cybricks0025-tech/surgical-sealant/README.md

# Surgical Sealant 雙腔注射混合頭（v2，已重新驗證）

[3D 線上展示](https://cybricks0025-tech.github.io/surgical-sealant/)

針對 PEG-SG／PEG-SH + T-buffer（pH 觸發交聯）雙腔注射系統，設計 3D 列印用的 **SHM（Staggered Herringbone）被動式混合流道**。

> **v2 說明**：2026-10 重新驗證後，v1 有數項不成立的宣稱已撤回或修正。所有估算可用 `verify_design.py` 重現。數值皆為**量級估算，非 CFD、非實驗結果**。

## 驗證結果摘要

| 項目 | v1 宣稱 | v2 驗證結論 |
|---|---|---|
| 縮頸孔（Ø0.35 / Ø0.80）保證 1:1 | 流阻補償 50× 黏度差 | ❌ `(0.80/0.35)⁴ = 27.3 ≠ 50`；且推桿聯動時配比由排量決定，流阻只影響壓力。改為對稱等體積入口 |
| Re ≈ 0.15 | 低雷諾數 | ⚠️ 重算約 20（混合液）～200（水相）。仍為層流，結論不變 |
| 溝槽 80 µm、混合段 8 mm | SHM 混勻 <0.05 s | ❌ 深寬比 0.08 偏低且過短，外推出口條紋仍約 1 mm。v2：深 0.15／高 0.5 = 0.30、長 28.8 mm → 約 14 µm |
| 剪切 >1200 s⁻¹ 拉直 PEG 鏈 | Coil-to-stretch | ❌ 10–20 kDa PEG 鬆弛時間 ~10⁻⁸–10⁻⁷ s，Wi ≈ 10⁻⁵–10⁻³ ≪ 1。已移除淚滴微柱 |
| pH 6→9.8 使 S⁻ 增加 >1000× | | ⚠️ 修正為約 575×（0.16% → 91%，pKa 8.8） |
| 十字閥「絕不堵槍」 | Stop-and-Go | ❌ 停推後管內仍會成膠，閥門無法阻止；降為選配防滴 |
| 滯留體積 <35 µL | | ✅ 新幾何約 38 µL |

## 專利查核（Google Patents，部分完成）

- **US6969400B2**：實為 Cohesion Technologies 的「交聯聚合物組成物」專利（優先權 1995，已到期），**不是**針筒外罩／活塞夾專利。v1 的歸屬錯誤。
- **US6328229B1**：Cohesion，優先權 1998，Expired。
- **EP2213245B1**：Baxter，優先權 2006，EP 狀態 Not-in-force；但美國延續案（US11896939B2、US12629445B2 等）狀態與 claims 尚未確認。
- 其餘專利（US9381005、US6835186、US7135027、US7951108、US7938296、US8074843、US8641661）**尚未逐件核對**。

本專案不構成法律意見；請以專利原文獨立項與專利代理人的 FTO 為準。

## 建議的驗證實驗

1. 預混對照：A、B 各 100 µL 快速吸吐混合後量成膠時間。≈10 s 代表瓶頸在化學，換混合頭無效。
2. 混合後最終 pH（不含 PEG）。
3. 用固定針頭＋砝碼＋甘油標準品量 A 相黏度。
4. 以 thymolphthalein／phenolphthalein 指示劑配合透明樹脂列印，直接觀察 pH 躍遷位置。
5. 同時列印凹槽深 0.10／0.15／0.20 mm，確認解析度。

## 檔案

- `index.html`／`interactive_3d_viewer.html`：3D 互動展示（含截面混合視窗，可用 `#step=2&theme=dark` 直接開啟特定步驟）
- `verify_design.py`：量級估算腳本
- `mixing_tip_prototype.scad`：v1 的 OpenSCAD 檔，**尚未更新為 v2 幾何**，列印前請勿直接使用
