cybricks0025-tech/surgical-sealant/COSEAL對照品分析測試計畫書.md

# COSEAL® (4 mL) 市售對照品拆解、保存與全項分析測試計畫書

* **專案名稱**：手術封合劑（Surgical Sealant）開發計畫
* **文件編號**：SOP-COSEAL-001
* **測試樣品**：Baxter COSEAL® Surgical Sealant 4 mL 市售實品套組（共 1 組）
* **預估總量**：混合乾粉總重約 $800\text{ mg}$（$4\text{S-PEG} : 4\text{T-PEG} = 1 : 1$）；稀鹽酸液約 $2.0\text{ mL}$；鹼性緩衝液約 $2.0\text{ mL}$
* **核心策略**：**嚴禁將整支針筒直接混合溶解**（混合後 2 小時內即失效）。採「**乾粉無水無氧分裝保存、依測試需求微量配製（Method B 兩階段法）**」，最大化建立化學、滅菌基準與體外機械物性對標數據。

---

## 一、 4 mL 樣品配額分配與實驗總覽表

為確保 $4\text{ mL}$（約 $800\text{ mg}$ 乾粉）市售品發揮最大效益，排除高耗量或暫不執行之 NMR 與 HPLC 項目，整體配額規劃如下：

| 階段 | 分析類別 | 具體檢測項目 | 使用儀器 / 工具 | 預估消耗量（乾粉 / 緩衝液） | 對應《可行性評估報告》關鍵目標 |
| :--- | :--- | :--- | :--- | :--- | :--- |
| **第一階段** | **包裝與器材逆向工程** | 1. 鋁箔袋封裝狀態與乾燥劑規格<br>2. 乾粉實際總重與兩液實際體積<br>3. 雙腔注射器與靜態混合噴頭解析 | 精密天平、微量移液器、游標卡尺、相機 | **$0\text{ mg}$ (無損耗)**<br>*(全數回收分裝)* | 確立 Gamma 滅菌防潮包裝規格、驗證 $20\%\text{ (w/v)}$ 固含量、雙腔混合器設計參考 |
| **第二階段** | **基礎化學與光譜分析** | 1. 原廠 S-buffer 與 T-buffer 真實 pH<br>2. 預混乾粉與凍乾水凝膠之化學指紋<br>3. 4S-PEG (NHS) 與 4T-PEG (SH) 活性<br>4. 滅菌後真實分子量 ($M_w/M_n$) 與 PDI | 1. pH 計 (微電極)<br>2. ATR-FTIR<br>3. UV-Vis ($260 / 412\text{ nm}$)<br>4. GPC (水相 SEC) | **約 $25\text{ mg}$ 乾粉**<br>*(約折合 $0.125\text{ mL}$ 膠體 + 微量緩衝液)* | 建立市售品滅菌後之化學基準：確認觸發成膠 pH、NHS 取代率 ($\ge 80\%$)、SH 活性與 $10\text{ kDa}$ 分子量 |
| **第三階段** | **成膠動力學與膨潤降解** | 1. 起始成膠時間與完全固化時間<br>2. 體外溶脹比 ($V/V_0$, $117\text{ hr}$)<br>3. 體外水解降解時間（重量損失曲線）<br>4. 交聯副產物 NHS 累積釋放率 ($30\text{ min}$) | 碼錶、PTFE 圓盤模具 ($\varnothing 10 \times 2.5\text{ mm}$)、$37^\circ\text{C}$ 震盪培養箱、UV-Vis ($284\text{ nm}$) | **$80\text{ mg}$ 乾粉 ($n=2$)**<br>*(配製 $0.2\text{ mL} \times 2 = 0.4\text{ mL}$ 膠體，一魚四吃)* | 對標原廠起始成膠 $3\text{--}5\text{ s}$、完全固化 $\le 60\text{ s}$、溶脹比 $4.3\pm 0.6$ 倍、NHS 釋放 $\ge 75\%$ |
| **第四階段** | **機械物性對標測試** | 1. 單軸壓縮模數（Compression Modulus）<br>2. 狗骨頭拉伸模數與斷裂伸長率 *(選做)* | 萬能材料試驗機 (Instron/Zwick)、鐵氟龍模具 ($\varnothing 10 \times 4\text{ mm}$) | **$190\text{ mg}$ 乾粉 ($n=3$)**<br>*(壓縮 $0.31\text{ mL} \times 3 \approx 0.95\text{ mL}$；若加做拉伸 $n=1$ 需 $0.8\text{ mL}$)* | **填補報告表 8「壓縮模數」與「拉伸模數」之待訂規空白**（對標文獻壓縮 $91\pm 41\text{ kPa}$） |
| **第五階段** | **封合功能對標測試** | 1. 豬頸動脈 / PTFE 人工血管針孔洩漏壓<br>2. 膠原蛋白腸衣爆破壓 ($2\text{ mm}$ 缺損) | 注射泵加壓防水測試平台、壓力計、膠原蛋白腸衣 / 豬血管 | **$400\text{--}500\text{ mg}$ 乾粉**<br>*(約 $2.0\text{--}2.5\text{ mL}$ 膠體，依項目分配)* | 在所內自建機台上建立 COSEAL 實品爆破壓（$\ge 100\text{ mmHg}$）與洩漏壓（$\ge 200\text{ mmHg}$）基準線 |
| **備用留樣** | **緊急複測留樣** | 保存於 $-20^\circ\text{C}$ 充氮乾燥環境，供後續滅菌批次同盤比對 | 充氮氣密玻璃瓶 | **約 $5\text{--}105\text{ mg}$ 乾粉** | 保留市售品實體對照標準 |

---

## 二、 第一階段：拆封、無水無氧分裝與保存 SOP

> **⚠️ 操作核心原則**：COSEAL 粉末針筒內為 **4-arm PEG-NHS (4S-PEG)** 與 **4-arm PEG-SH (4T-PEG)** 之預混乾粉。前者遇空氣濕氣極易水解失去交聯能力，後者遇氧氣易形成二硫鍵（$-\text{S}-\text{S}-$）。**拆封與分裝必須全程於手套箱（充氮/氬氣）或極低濕度環境下快速完成。**

### 2.1 拆封前準備清單
- [ ] 手套箱（或充氮袋、氮氣鋼瓶吹掃裝置）、除濕機（環境相對濕度控制在 $< 30\%$）
- [ ] 四位數精密分析天平、防靜電稱量紙 / 藥勺（預先烘乾冷卻）
- [ ] 琥珀色氣密玻璃樣品瓶（$1.5\text{ mL} / 2.0\text{ mL}$ 規格，預先洗淨並於 $105^\circ\text{C}$ 烘乾除水）共 $8\text{--}10$ 支
- [ ] 無菌低吸附微量離心管（Eppendorf，分裝緩衝液用）共 $4\text{--}6$ 支
- [ ] 封口膜（Parafilm）、鋁箔夾鏈袋、乾燥劑（矽膠或分子篩）

### 2.2 拆解與包裝逆向紀錄步驟
1. **外包裝與液體組件包拆解**：
   * 拆開外盒，取出「液體組件包（Liquid Component Pouch）」與「粉末組件包（Powder Component Pouch）」及塗藥器噴頭。
   * 先拆開「液體組件包」，取下雙腔注射器（Dual-syringe system）。觀察並拍照記錄傳送封口（Transfer port closure）、柱塞連桿與防誤壓夾（Plunger clip）機構。
   * 將雙腔注射器內預裝的兩管液體分別全數抽出至已秤重之無菌離心管中，精確秤重並量測體積：
     * **A 管（稀鹽酸溶液，S-buffer）**：驗證體積是否約為 $2.0\text{ mL}$。
     * **B 管（磷酸鈉/碳酸鈉溶液，T-buffer）**：驗證體積是否約為 $2.0\text{ mL}$。
   * 將抽出之原廠 S-buffer 與 T-buffer 充氮密封，置於 **$2^\circ\text{C}\text{--}8^\circ\text{C}$ 冷藏保存**（切勿冷凍以免碳酸鹽/磷酸鹽結晶析出改變 pH）。
2. **粉末組件包拆解與分裝**：
   * 在手套箱或充氮環境下，剪開「粉末組件包」鋁箔袋。
   * **立即檢查並記錄**：(1) 鋁箔袋是否有抽真空或充氮氣鼓起？ (2) 內部乾燥劑之材質（如 Silica gel 或 Molecular sieve）、包裝形式與實際總重量（g）。
   * 拆開粉末針筒，將內部預混 PEG 乾粉全數倒出並精確秤量**「總乾粉實際重量」**（預期約 $800\text{ mg}$）。
   * 依後續實驗單次用量，直接分裝至烘乾之琥珀色氣密玻璃瓶中（建議分裝規格如下）：
     * **分析瓶 #1（化學分析專用）**：裝入 **$30\text{ mg}$**（供 FT-IR、UV-Vis、GPC 使用）
     * **物性瓶 #2（溶脹與降解測試，$n=2$）**：裝入 **$80\text{ mg}$**（對應 $0.4\text{ mL}$ 膠體）
     * **物性瓶 #3（單軸壓縮測試，$n=3$）**：裝入 **$200\text{ mg}$**（對應 $1.0\text{ mL}$ 膠體）
     * **功能瓶 #4（血管洩漏壓測試，$n=2\text{--}3$）**：裝入 **$200\text{ mg}$**（對應 $1.0\text{ mL}$ 膠體）
     * **功能瓶 #5（腸衣爆破壓或拉伸測試）**：裝入 **$200\text{ mg}$**（對應 $1.0\text{ mL}$ 膠體）
     * **備用瓶 #6（剩餘留樣）**：裝入剩餘約 **$90\text{ mg}$**
   * 每支玻璃瓶填入乾粉後，向瓶內吹入高純度氮氣（$\text{N}_2$）置換空氣 5 秒，立即旋緊瓶蓋、纏繞 Parafilm 兩圈，連同原廠乾燥劑裝入鋁箔夾鏈袋密封，置於 **$-20^\circ\text{C}$ 冷凍避光保存**。*(註：每次取用前，必須先從冰箱取出置於乾燥箱回溫至室溫約 20 分鐘後才可開蓋，避免空氣水氣冷凝於冰冷粉末上！)*

### 2.3 微量配製標準操作法（Method B 兩階段還原法）
由於市售品粉末已將 4S-PEG 與 4T-PEG 預混，後續所有物性測試**必須採用說明書之兩階段配製法（Method B）**，按比例微縮配製：
* **標準配製比例（$20\%\text{ w/v}$ 總固含量）**：每 **$100\text{ mg}$ 混合乾粉**，對應 **$250\text{ }\mu\text{L}$ 稀鹽酸液（S-buffer）** 與 **$250\text{ }\mu\text{L}$ 鹼性緩衝液（T-buffer）**，最終可形成 **$0.50\text{ mL}$ 水凝膠**。
* **操作流程**：
  1. **第一階段（酸溶抑制反應）**：於每 $100\text{ mg}$ 乾粉中加入 $250\text{ }\mu\text{L}$ 原廠稀鹽酸液（或自配 pH 6.0 S-buffer），以 Vortex 或雙針筒推吸混勻 1–2 分鐘至完全澄清透明且無氣泡（此時 pH 為弱酸性，$-\text{SH}$ 不反應，可穩定放置準備模具）。
  2. **第二階段（鹼液觸發交聯）**：準備好模具與碼錶後，加入等體積（$250\text{ }\mu\text{L}$）之原廠鹼性緩衝液（T-buffer），以微量移液器快速推吸 1–2 下（或透過迷你雙腔混合頭擠出）於 **2 秒內注入模具**並啟動計時。

---

## 三、 第二階段：基礎化學與光譜分析 SOP（排除 NMR / HPLC）

### 3.1 原廠緩衝液 pH 值與混合後觸發 pH 測定
* **消耗量**：S-buffer $50\text{ }\mu\text{L}$ + T-buffer $50\text{ }\mu\text{L}$（測完若未汙染可回收作為稀釋液）。
* **操作步驟**：
  1. 使用微量 pH 電極（或高精密 pH 試紙輔助），單獨量測原廠 **稀鹽酸液（S-buffer）** 之實際 pH 值（驗證文獻推估值 pH 6.0）。
  2. 單獨量測原廠 **磷酸鈉/碳酸鈉緩衝液（T-buffer）** 之實際 pH 值（驗證文獻推估值 pH 9.6）。
  3. 取 $20\text{ }\mu\text{L}$ S-buffer 與 $20\text{ }\mu\text{L}$ T-buffer 進行 **1 : 1 等體積混合**，量測混合瞬間的最終反應環境 pH 值（預期落在 pH 8.8–9.4 之間），以此作為自製配方調整 T-buffer 緩衝容量以縮短成膠時間（由 8–10 秒縮短至 3–5 秒）的核心依據。

### 3.2 衰減全反射傅立葉紅外光譜（ATR-FTIR）分析
* **消耗量**：取分析瓶 #1 之乾粉 **$1\text{--}2\text{ mg}$**（非破壞性，乾燥環境下測完可回收）。
* **操作步驟與觀測重點**：
  1. **嚴禁使用 KBr 壓片法**（KBr 吸濕會導致 NHS 酯瞬間水解）。直接將 $1\text{--}2\text{ mg}$ COSEAL 乾粉置於 ATR 鑽石晶體表面壓緊掃描（範圍 $4000\text{--}600\text{ cm}^{-1}$）。
  2. **關鍵特徵峰比對**：
     * **$1740\text{ cm}^{-1}$**（酯基 $\text{C=O}$ 拉伸）及 **$1780, 1810\text{ cm}^{-1}$**（琥珀醯亞胺環 Succinimidyl $\text{C=O}$ 雙峰）：驗證活性 NHS 酯強度。
     * **$2880\text{ cm}^{-1}$**（$\text{C-H}$ 拉伸）與 **$1100\text{ cm}^{-1}$**（PEG 主鏈 $\text{C-O-C}$ 醚鍵拉伸）：作為內標準峰（Internal Standard）。
     * 計算峰高比值 **$I_{1740} / I_{1100}$**，與本所自製未滅菌/已滅菌混粉疊圖比對。
     * 觀察 **$1710\text{ cm}^{-1}$**（游離羧酸 $-\text{COOH}$）與 **$3300\text{--}3500\text{ cm}^{-1}$**（$-\text{OH}$ 水分），評估原廠滅菌後之背景水解程度。
  3. **成膠後結構確認（配合物性測試後進行）**：將第三或第四階段測試完畢之固化水凝膠冷凍乾燥（Lyophilization）後掃描 ATR-FTIR，確認 $1740 / 1780 / 1810\text{ cm}^{-1}$ 之 NHS 峰消失，並於 **$1685\text{--}1695\text{ cm}^{-1}$** 出現交聯產物**硫酯鍵（Thioester $\text{C=O}$）**特徵峰。

### 3.3 UV-Vis 定量 4S-PEG 與 4T-PEG 有效官能基取代率（無交聯風險兩階段法）
* **原理說明**：為避免預混乾粉直接接觸鹼液發生局部交聯結塊，先以 **pH 6.0 弱酸緩衝液** 將乾粉完全溶解並稀釋至 $0.2\%\text{ (w/v)}$（較正常成膠濃度 $20\%$ 稀釋 100 倍，低於臨界成膠濃度，完全杜絕成膠風險），再同一管分流測定 **NHS 取代率（260/284 nm）** 與 **SH 硫醇取代率（412 nm）**。
* **消耗量**：取分析瓶 #1 之乾粉 **$4.0\text{ mg}$**。
* **操作步驟**：
  1. **配製不交聯弱酸性母液**：精確秤取 **$4.0\text{ mg}$** COSEAL 混合乾粉（內含 **$2.0\text{ mg}$ 4S-PEG** 與 **$2.0\text{ mg}$ 4T-PEG**），加入 **$2.0\text{ mL}$ 自配 S-buffer（pH 6.0 磷酸鹽緩衝液或 pH 5.2 醋酸鈉緩衝液）**，Vortex 震盪 2 分鐘至完全溶解澄清（此時 4S-PEG 與 4T-PEG 個別濃度皆為 $1.0\text{ mg/mL} = 0.1\text{ mM}$ 高分子濃度，理論最大官能基濃度 $C_{\text{theoretical}} = 0.1\text{ mM} \times 4\text{ arms} = 0.40\text{ mM}$）。
  2. **測定 4S-PEG 之 NHS 酯有效取代率（Miron & Wilchek 法，UV 260 nm / 284 nm）**：
     * **背景游離組（測包裝內已水解失效之 NHS，$A_0$）**：取 **$200\text{ }\mu\text{L}$** 酸性母液 + **$800\text{ }\mu\text{L}$ S-buffer（pH 6.0）**（稀釋 5 倍，理論最大濃度 $C_{\text{theo}} = 0.08\text{ mM}$），立即於 UV-Vis 讀取 $260\text{ nm}$（或 $284\text{ nm}$）吸光值 $A_0$。
     * **完全釋放組（測總活性 NHS，$A_{\text{max}}$）**：取 **$200\text{ }\mu\text{L}$** 酸性母液 + **$800\text{ }\mu\text{L}$ 鹼性水解液（含 $0.05\text{ M }\text{NH}_4\text{OH}$ 或 $0.01\text{ M }\text{NaOH}$ 之 PBS 緩衝液）**（此時總高分子濃度僅 $0.04\%\text{ w/v}$，絕不結塊成膠）。室溫反應 15–20 分鐘使接在 PEG 上之活性 NHS 酯 $100\%$ 斷裂轉化為游離 $\text{NHS}^-$ 陰離子，讀取吸光值 $A_{\text{max}}$。
     * **計算公式**：將 $(A_{\text{max}} - A_0)$ 代入本所已建立之 NHS 標準品檢量線（$R^2 > 0.98$），求得有效釋放之活性 NHS 濃度 $\Delta C_{\text{active}}\text{ (mM)}$：
       $$\text{4S-PEG 有效官能基取代率 (\%)} = \left( \frac{\Delta C_{\text{active}}}{0.08\text{ mM}} \right) \times 100\% \quad (\text{對標規格 } \ge 80\%)$$
  3. **測定 4T-PEG 之游離硫醇基（$-\text{SH}$）有效取代率（Ellman's Reagent / DTNB 法，UV 412 nm）**：
     * 取上述步驟 1 剩餘之酸性母液 **$200\text{ }\mu\text{L}$**，加入含有過量 **DTNB（5,5'-Dithiobis-(2-nitrobenzoic acid)）** 之反應緩衝液（pH 7.4–8.0 磷酸鹽緩衝液，含 $1\text{ mM}$ EDTA）湊滿 $1.0\text{ mL}$。
     * 室溫避光反應 10 分鐘（DTNB 與 $-\text{SH}$ 瞬間定量生成黃色 $\text{TNB}^{2-}$ 離子），於 UV-Vis **$412\text{ nm}$** 讀取吸光值（莫耳消光係數 $\varepsilon_{412} = 14,150\text{ M}^{-1}\text{cm}^{-1}$，或代入半胱胺酸 Cysteine 檢量線），求得有效 $-\text{SH}$ 濃度 $C_{\text{SH}}$：
       $$\text{4T-PEG 有效硫醇取代率 (\%)} = \left( \frac{C_{\text{SH}}}{0.08\text{ mM}} \right) \times 100\%$$

### 3.4 凝膠滲透層析（GPC）測定滅菌後分子量與多分散性（PDI）
* **消耗量**：取分析瓶 #1 之乾粉 **$10\text{--}15\text{ mg}$**。
* **操作步驟**：
  1. 將乾粉溶於 **弱酸性水相移動相（如 pH 5.2 醋酸鈉水溶液或含 $0.05\%\text{ NaN}_3$ 之弱酸緩衝液，濃度 $5\text{--}10\text{ mg/mL}$）**，確保 $-\text{SH}$ 與 $-\text{NHS}$ 在層析過程中不發生交聯反應。
  2. 經 $0.22\text{ }\mu\text{m}$ 濾膜過濾後進樣至水相 GPC 系統（RI 折射率偵測器）。
  3. **觀測指標**：
     * 測定主峰之重量平均分子量（$M_w$）、數目平均分子量（$M_n$）與多分散性指標（$\text{PDI} = M_w / M_n$），驗證是否維持在 **$10,000\text{ Da}$**。
     * 檢查低分子量區域（$< 5,000\text{ Da}$）有無因 Gamma 滅菌造成的**高分子斷鏈峰**，以及高分子量區域（$\approx 20,000\text{ Da}$）有無因 4T-PEG 氧化形成二硫鍵之**雙聚體峰（Dimer）**。

---

## 四、 第三階段：成膠動力學、體外溶脹比與降解測試 SOP（一魚四吃法）

本階段僅消耗 **物性瓶 #2（$80\text{ mg}$ 乾粉，配製 $0.4\text{ mL}$ 膠體，分為 $0.2\text{ mL} \times 2$ 組，$n=2$）**，即可同步完成**成膠時間、體外溶脹比、NHS 累積釋放曲線與體外降解時間**四項核心指標！

### 4.1 實驗材料與配製（Method B）
1. 取出 **物性瓶 #2（含 $80\text{ mg}$ 乾粉）** 回溫至室溫。
2. 先加入 **$200\text{ }\mu\text{L}$ 原廠稀鹽酸液（S-buffer）** 完全溶解乾粉，分成兩管（每管含 $40\text{ mg}$ 乾粉於 $100\text{ }\mu\text{L}$ S-buffer 中，對應單顆 $0.2\text{ mL}$ 樣品）。
3. 準備 PTFE 圓盤模具（直徑 $10\text{ mm}$，厚度約 $2.5\text{ mm}$，底部鋪設膠原蛋白腸衣或置於鐵氟龍板上）。

### 4.2 測試項目 1：起始成膠時間與完全固化時間
1. 於單管（$100\text{ }\mu\text{L}$ 酸溶 PEG 液）中加入 **$100\text{ }\mu\text{L}$ 原廠鹼性緩衝液（T-buffer）**，以移液器快速推吸 1 下（約 1 秒）立即注入圓盤模具中，同步按下碼錶。
2. **記錄「起始成膠時間（流動變慢/拉絲時間）」**：對標 COSEAL IFU 規格 **$3\text{--}5\text{ 秒}$**（本所自製樣品目前為 $8\text{--}10\text{ 秒}$）。
3. **記錄「完全固化時間（傾斜模具停止流動時間）」**：對標 COSEAL IFU 規格 **$\le 60\text{ 秒}$**（本所自製樣品為 $45\text{--}60\text{ 秒}$），並記錄水凝膠外觀（是否完全透明柔軟或帶有微氣泡白霧）。
4. 靜置於室溫保濕環境下交聯固化 **30 分鐘**。

### 4.3 測試項目 2 & 3：反應 30 分鐘 NHS 累積釋放率 & 體外溶脹比（$117\text{ hr}$）
1. 固化滿 30 分鐘後，將兩顆圓盤水凝膠（$n=2$）脫模，精確秤量**起始濕重 $W_0$** 並以游標卡尺量測**起始直徑 $D_0$ 與厚度 $H_0$（計算起始體積 $V_0$）**。
2. 將每顆圓盤分別放入裝有 **$10\text{ mL}$ PBS（pH 7.2–7.4）** 之樣品瓶中，置於 **$37^\circ\text{C}$ 恆溫震盪烘箱**中搖晃浸泡。
3. **【一魚兩吃】反應副產物 NHS 累積釋放率測定（UV-Vis 284 nm）**：
   * 於浸泡後第 **$5, 10, 15, 30, 60\text{ 分鐘}$**，分別抽取 $100\text{ }\mu\text{L}$ PBS 浸泡上清液（測完可倒回或補入新鮮 PBS），以 UV-Vis 測量 **$284\text{ nm}$** 吸光值。
   * 代入 NHS 檢量線，計算第 30 分鐘之 **NHS 累積釋放率（%）**（對標規格 $\ge 75\%$，本所自製樣品已驗證為 $80.1\%$），藉此直接反推市售品水凝膠之真實交聯完整度。
4. **【一魚三吃】體外溶脹比（Swellability）測定**：
   * 於浸泡第 **$1, 2, 4, 24, 48, 72, 96, 117\text{ 小時}$** 定時取出水凝膠，以拭鏡紙輕吸表面多餘水分後，秤量溶脹後重量 $W_t$ 與體積 $V_t$，並更換新鮮 PBS。
   * 計算重量溶脹比（$W_t / W_0$）與體積溶脹比（$V_t / V_0$），對標 COSEAL 標竿值 **$4.3 \pm 0.6$ 倍**（釐清本所自製樣品 $5.27$ 倍與市售品在相同模具下是否一致）。

### 4.4 測試項目 4：【一魚四吃】體外水解完全降解時間（Degradation）
1. 完成 $117\text{ 小時}$（約 5 天）溶脹測試後，不丟棄樣品，繼續維持於 $37^\circ\text{C}$ PBS 中每日觀察並秤重。
2. 記錄水凝膠硫酯鍵（Thioester bond）發生水解明膠化、重量急遽下降直至**肉眼完全溶解消失之總時數/天數**（文獻記載體外薄層約 $70\text{--}100\text{ 小時}$ 或 $6\text{--}14\text{ 天}$ 內完全水解）。

---

## 五、 第四階段：機械物性對標測試 SOP（填補報告表 8 規格空白）

在《可行性評估報告》表 8 中，「壓縮模數」與「拉伸模數」目前為待訂規。本階段優先執行耗量小且具統計意義之**單軸壓縮測試（$n=3$）**。

### 5.1 單軸壓縮模數測試（Uniaxial Compression Test）
* **消耗量**：取 **物性瓶 #3（約 $190\text{--}200\text{ mg}$ 乾粉）**，配製約 **$0.95\text{--}1.0\text{ mL}$** 膠體，製作 **$n=3$** 顆標準圓柱試片。
* **模具規格**：鐵氟龍（PTFE）圓柱形模具，**直徑 $10\text{ mm}$（$1\text{ cm}$）、厚度 $4\text{ mm}$**（單顆理論體積 $= \pi \times (0.5\text{ cm})^2 \times 0.4\text{ cm} = 0.314\text{ mL}$，單顆需乾粉 $62.8\text{ mg}$）。
* **操作步驟**：
  1. 建議**逐顆配製（每次取 $65\text{ mg}$ 乾粉 + $162.5\text{ }\mu\text{L}$ S-buffer 溶解後，再加 $162.5\text{ }\mu\text{L}$ T-buffer 混合注模）**，避免一次配製 $1\text{ mL}$ 時在移液器內過早固化導致第 3 顆試片不均勻。
  2. 注入鐵氟龍模具後，上方蓋上平滑玻片或鐵氟龍片確保上下表面平行，於室溫下交聯固化 **20–30 分鐘** 後小心脫模。
  3. **萬能材料試驗機（Instron / Zwick）參數設定**（完全參照文獻標準）：
     * **預載荷重（Pre-load）**：$0.1\text{ N}$
     * **壓縮速度（Crosshead speed）**：$1.0\text{ mm/min}$
     * **終點形變量（Max strain）**：壓縮至形變量 **$80\%$**（即厚度由 $4.0\text{ mm}$ 壓至 $0.8\text{ mm}$）
  4. **數據計算**：繪製應力-應變曲線（Stress-Strain curve，確認水凝膠指數行為特性曲線），並計算 **形變量 $15\%$ 到 $20\%$ 區間之割線斜率作為壓縮模數（Compressive Modulus, kPa）**，對標文獻值 **$91 \pm 41\text{ kPa}$**，正式填入報告表 8！

### 5.2 狗骨頭拉伸模數與斷裂伸長率測試 *(選做，視第五階段封合測試配額取捨)*
* **消耗量**：單支試片需 **$0.8\text{ mL}$** 膠體（對應 **$160\text{ mg}$ 乾粉**，$n=1$）。
* **模具與方法**：使用長 $4\text{ cm}$、頸部寬 $0.5\text{ cm}$、厚約 $4\text{ mm}$ 之狗骨頭模具（底部鋪設膠原蛋白膜），注入 $0.8\text{ mL}$ 混合液，室溫交聯 **20 分鐘**後上機拉伸至斷裂，記錄斷裂強度（文獻值 $0.024 \pm 0.002\text{ MPa}$）、斷裂伸長率（文獻值 $72 \pm 6\%$）及初始線性區段之**拉伸模數（Tensile Modulus）**。

---

## 六、 第五階段：體外封合功能對標測試 SOP（爆破壓與洩漏壓）

利用最後剩餘約 **$400\text{--}500\text{ mg}$ 乾粉（約 $2.0\text{--}2.5\text{ mL}$ 膠體）**，於本所已建立之「注射泵防水加壓測試平台」上實測 COSEAL 市售品，與本所自製配方（腸衣爆破壓 $279.5\text{--}367.8\text{ mmHg}$、豬頸動脈洩漏壓 $662.0\text{ mmHg}$）進行同機台直接對決。

### 方案 A（推薦優先執行，省料且具重複數）：Ex vivo 豬頸動脈 / PTFE 人工血管針孔密封洩漏壓（Leakage Pressure）
* **消耗量**：單次測試僅需局部塗覆 **$0.5\text{--}0.6\text{ mL}$** 膠體（對應 $100\text{--}120\text{ mg}$ 乾粉），可執行 **$n=2\text{--}3$ 組**重複實驗。
* **操作步驟**：
  1. 取直徑 $3\text{--}6\text{ mm}$ 之豬頸動脈（或直徑 $6\text{ mm}$ 之 PTFE 人工血管移植物），以標準針頭刺出直徑 **$0.6\text{ mm}$（或 $0.4\text{--}0.9\text{ mm}$）之穿刺缺損**。
  2. 將血管一端連接注射泵加壓管路、另一端連接數位壓力計。先不塗封合劑通水測試未密封之基線洩漏壓（文獻約 $11\text{--}18\text{ mmHg}$）。
  3. 擦乾血管表面水分，取 $100\text{ mg}$ COSEAL 乾粉以 $250\text{ }\mu\text{L}$ S-buffer 溶解後，與 $250\text{ }\mu\text{L}$ T-buffer 快速混合（共 $0.5\text{ mL}$），均勻塗覆包覆於穿刺缺損處，靜置固化 **3 分鐘**。
  4. 啟動注射泵以 **$5\text{ mL/min}$** 流速加壓注水，記錄封合膠體破裂或噴水瞬間之最高壓力值（**洩漏壓，mmHg**），並觀察記錄**破損模式（由凝膠中間內聚破裂 Cohesive failure，或由血管界面剝離 Adhesive failure）**。
  5. **對標標準**：目標規格 $\ge 200\text{ mmHg}$（文獻 PTFE 為 $400 \pm 50\text{ mmHg}$、豬頸動脈為 $660 \pm 150\text{ mmHg}$）。

### 方案 B（單次標準對標）：In vitro 膠原蛋白腸衣爆破壓測試（Burst Pressure）
* **消耗量**：若完全比照文獻標準用量需 **$2.0\text{ mL}$**（耗粉 $400\text{ mg}$，$n=1$）；若配合所內夾具局部塗覆可縮減至 **$1.0\text{ mL}$**（耗粉 $200\text{ mg}$）。
* **操作步驟**：
  1. 於測試圓盤中央（直徑 $2\text{ mm}$ 孔洞）覆蓋粗纖維膠原蛋白腸衣，並於腸衣正中央製造直徑 **$2\text{ mm}$ 標準孔洞**。
  2. 配製 COSEAL 混合液擠壓覆蓋於 $2\text{ mm}$ 孔洞上，室溫靜置固化 **3 分鐘**。
  3. 以注射泵 **$5\text{ mL/min}$** 流速加壓注水，記錄爆破瞬間之最高壓力（**爆破壓，mmHg**）與破裂型態。
  4. **對標標準**：目標規格 $\ge 100\text{ mmHg}$（文獻基準值為 $125 \pm 36\text{ mmHg}$）。

---

## 七、 建議實驗執行時程與順序（2 日密集實驗規劃）

* **Day 1 上午（無水拆封與化學分析）**：
  1. 手套箱拆封、包裝與乾燥劑拍照記錄、秤總重、分裝為 #1–#6 充氮玻璃瓶並入庫冷凍。
  2. 抽出兩管原廠緩衝液測體積，取微量測 **pH 值（S-buffer、T-buffer 及 1:1 混合液）**。
  3. 取分析瓶 #1（$30\text{ mg}$）完成 **ATR-FTIR 乾粉掃描**、配製弱酸母液完成 **UV-Vis（NHS 260 nm 與 SH 412 nm 取代率）** 及 **GPC 上機**。
* **Day 1 下午（成膠時間、溶脹降解啟動與壓縮測試）**：
  1. 取物性瓶 #2（$80\text{ mg}$）配製 $0.2\text{ mL} \times 2$ 圓盤，同步測 **成膠秒數**；固化 30 分鐘後泡入 $37^\circ\text{C}$ PBS，抽前 60 分鐘上清液測 **UV 284 nm NHS 釋放曲線**，並啟動 $117\text{ hr}$ 溶脹與降解追蹤。
  2. 取物性瓶 #3（$200\text{ mg}$）逐顆製作 3 顆直徑 $10\text{ mm}\times 4\text{ mm}$ 圓柱，上 Instron/Zwick 完成 **單軸壓縮模數測試（$n=3$）**。測試後之圓柱試片送冷凍乾燥，供次日測成膠後 FT-IR。
* **Day 2（體外封合爆破壓與洩漏壓測試）**：
  1. 取功能瓶 #4、#5（共 $400\text{ mg}$），於防水加壓測試平台上完成 **豬頸動脈洩漏壓（$n=2$）** 與 **膠原蛋白腸衣爆破壓（$n=1$）** 測試。

---

## 八、 COSEAL® 市售品實測數據紀錄表（列印填寫用）

**實驗日期**：2026 / ____ / ____　　**操作人員**：________________　　**COSEAL 批號 (Lot)**：________________　　**效期 (Exp)**：________________

| 編號 | 檢測類別 | 檢測項目與單位 | 文獻 / 原廠規格基準 | 本所自製樣品數據 | **COSEAL® 實測數據** | 備註 / 異常觀察 |
| :--- | :--- | :--- | :--- | :--- | :--- | :--- |
| **01** | **包裝逆向** | 粉末袋封裝狀態 / 乾燥劑規格 | 防潮鋁箔袋 + 乾燥劑 | 評估中 | 狀態：□真空 □充氮<br>乾燥劑：________ g | |
| **02** | **包裝逆向** | 乾粉實際總重 ($W_{\text{total}}$) | 推估 $\approx 800\text{ mg}$ | — | ____________ mg | |
| **03** | **包裝逆向** | S-buffer / T-buffer 實際體積 | 推估各 $2.0\text{ mL}$ | — | S: ____ mL / T: ____ mL | 換算固含量：____% |
| **04** | **溶液性質** | 緩衝液 pH 值（單獨 vs 1:1 混合） | S: $6.0$ / T: $9.6$ | S: $6.0$ / T: $9.6$ | S: ____ / T: ____<br>**1:1 混合 pH：____** | |
| **05** | **光譜分析** | ATR-FTIR 乾粉 $I_{1740} / I_{1100}$ 比值 | 具明顯 $1740\text{ cm}^{-1}$ 峰 | 對照組疊圖 | 比值：____________ | $1710\text{ cm}^{-1}$ 水解：□無 □微 |
| **06** | **化學活性** | 4S-PEG (NHS) 有效取代率 (%) | $\ge 80\%$ (臨界值 $55\%$) | $>80\%$ ($R^2=0.9814$) | ____________ % | 背景預水解率：____% |
| **07** | **化學活性** | 4T-PEG ($-\text{SH}$) 有效取代率 (%) | $\ge 70\text{--}80\%$ | 待對標 | ____________ % | SH : NHS 實測比：____ |
| **08** | **分子量** | GPC 分子量 ($M_w, M_n$) 與 PDI | $10,000\text{ Da}$ | 待對標 | $M_w$: ______ / PDI: ____ | 有無斷鏈/雙聚體：____ |
| **09** | **反應動力** | 起始成膠時間（黏度瞬間提升） | **$3\text{--}5\text{ sec}$** (IFU) | $8\text{--}10\text{ sec}$ | ____________ sec | |
| **10** | **反應動力** | 完全固化時間（停止流動） | **$\le 60\text{ sec}$** (IFU) | $45\text{--}60\text{ sec}$ | ____________ sec | 外觀：□透明 □白霧 |
| **11** | **交聯完整** | 反應 30 分鐘 NHS 累積釋放率 | $\ge 75\%$ | $80.1\%$ | ____________ % | UV $284\text{ nm}$ 監測 |
| **12** | **物理性質** | 體外溶脹比 ($V/V_0$, $117\text{ hr}$) | $4.3 \pm 0.6$ 倍 | $5.27$ 倍 | ____________ 倍 | $24\text{ hr}$ 溶脹：____倍 |
| **13** | **物理性質** | 體外 PBS 完全水解降解時間 | 約 $70\text{--}100\text{ hr}$ ($1\text{--}2$ 週) | 待對標 | ______ 小時 (____天) | |
| **14** | **機械性質** | **單軸壓縮模數 ($15\text{--}20\%$ 形變)** | **$91 \pm 41\text{ kPa}$** | **待訂規 (表 8)** | **____ $\pm$ ____ kPa** | $n=3$，填入報告表 8 |
| **15** | **機械性質** | 狗骨頭拉伸模數 / 斷裂伸長率 | 強度 $24\text{ kPa}$ / 伸長 $72\%$ | **待訂規 (表 8)** | 模數：______ kPa<br>伸長率：______ % | 選做項目 |
| **16** | **封合功能** | In vitro 膠原蛋白腸衣爆破壓 | $125 \pm 36\text{ mmHg}$ ($\ge 100$) | $279.5\text{--}367.8\text{ mmHg}$ | ____________ mmHg | 破損型態：__________ |
| **17** | **封合功能** | Ex vivo 豬頸動脈洩漏壓 ($0.6\text{ mm}$) | $660 \pm 150\text{ mmHg}$ ($\ge 200$) | $662.0\text{ mmHg}$ | ______ $\pm$ ______ mmHg | 破損型態：__________ |
