cybricks0025-tech/surgical-sealant/assets/mixer_sheets/mixer_sheet_1.png

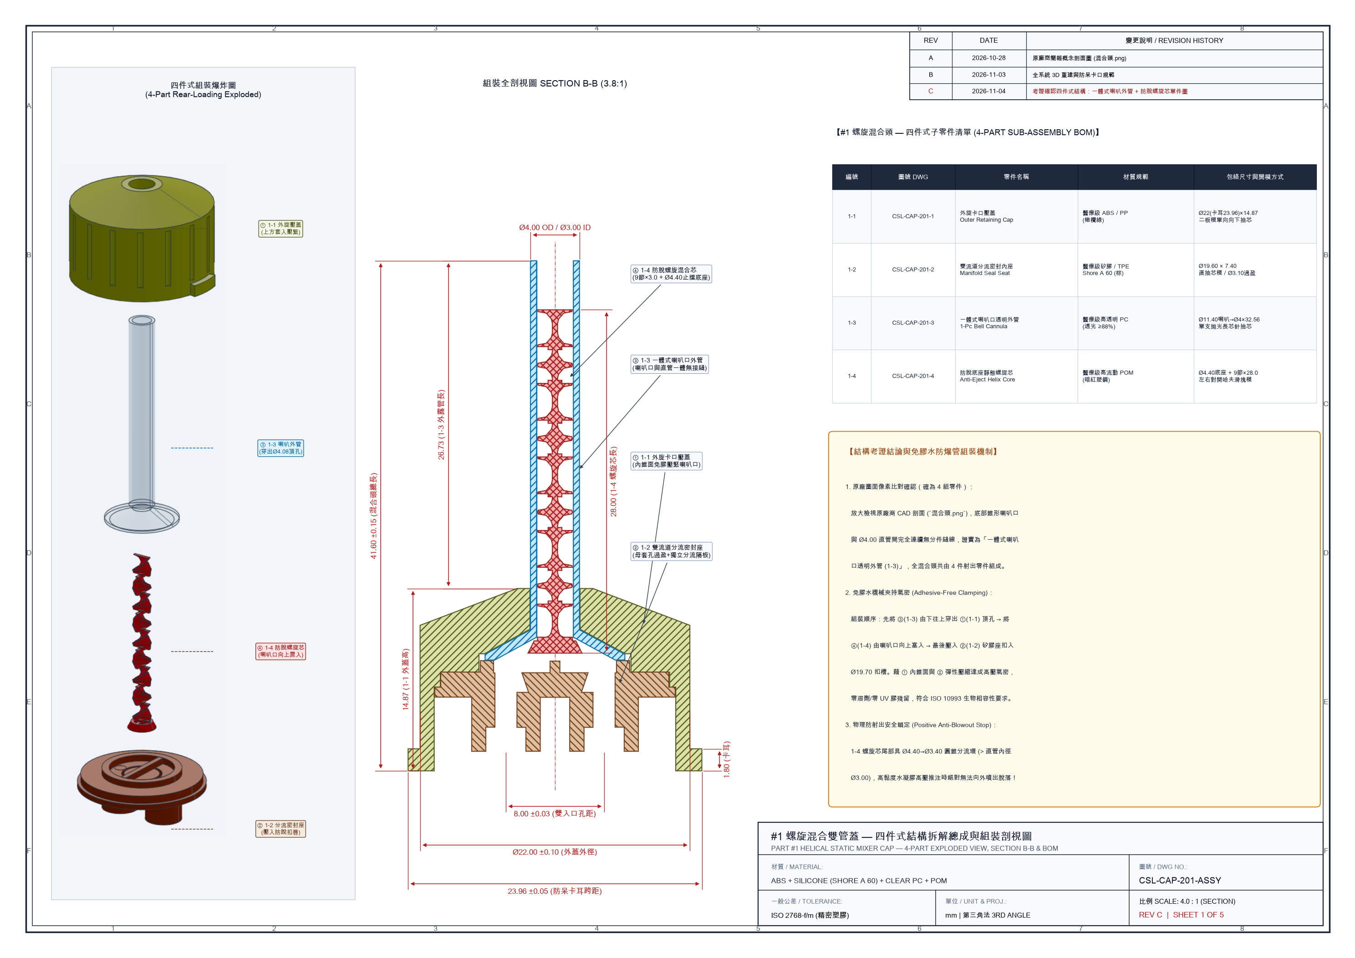
assets/mixer_sheets/mixer_sheet_1.png
