cybricks0025-tech/surgical-sealant/assets/sheets/sheet_1.png

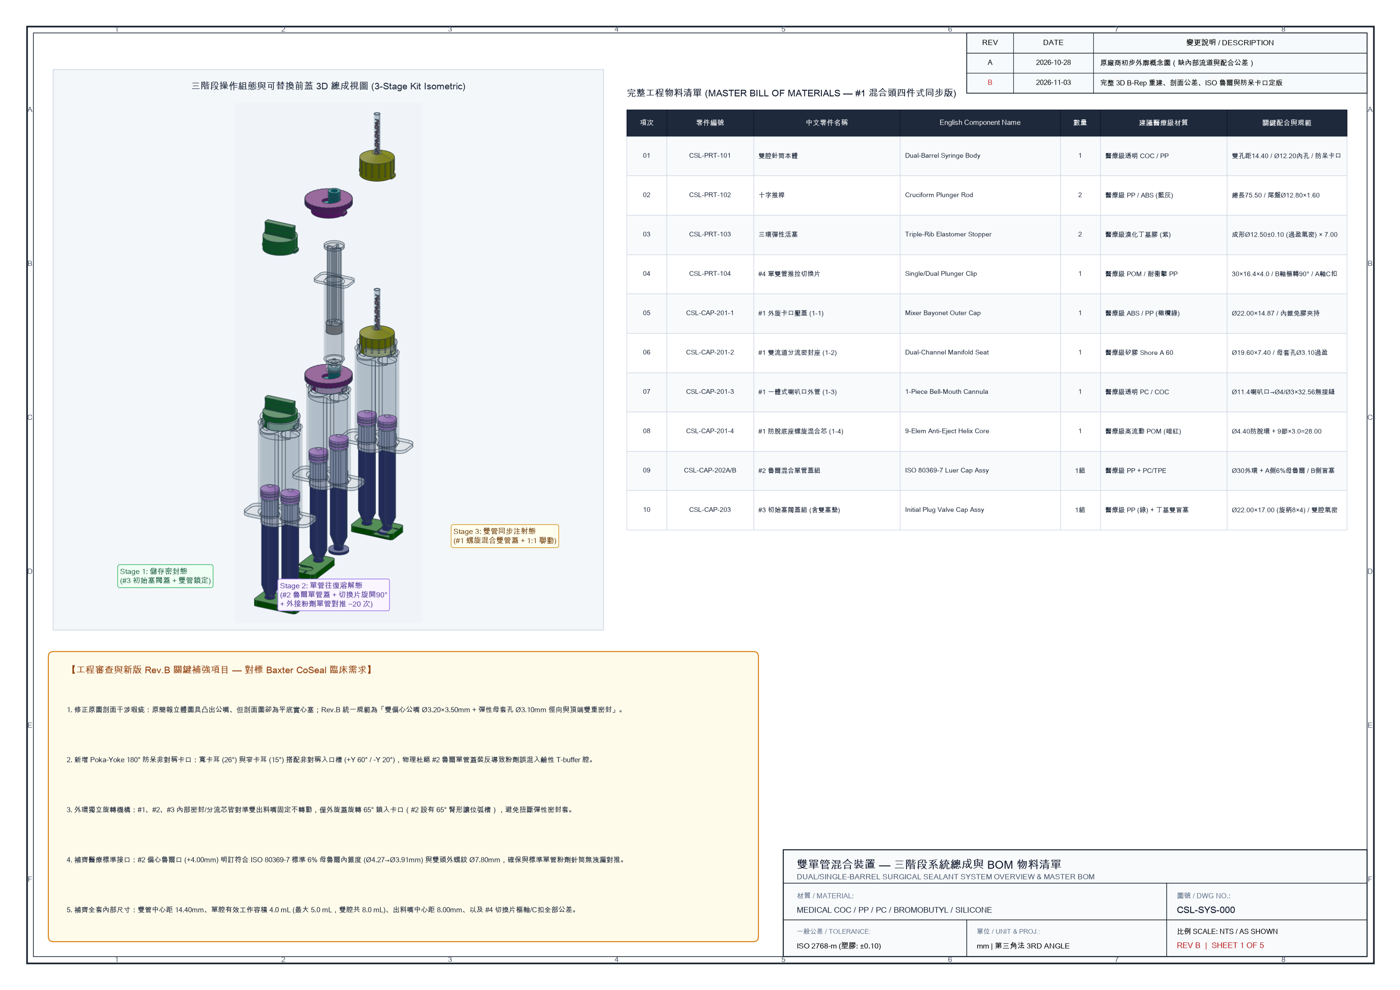
assets/sheets/sheet_1.png
