cybricks0025-tech/surgical-sealant/assets/sheets/sheet_2.png

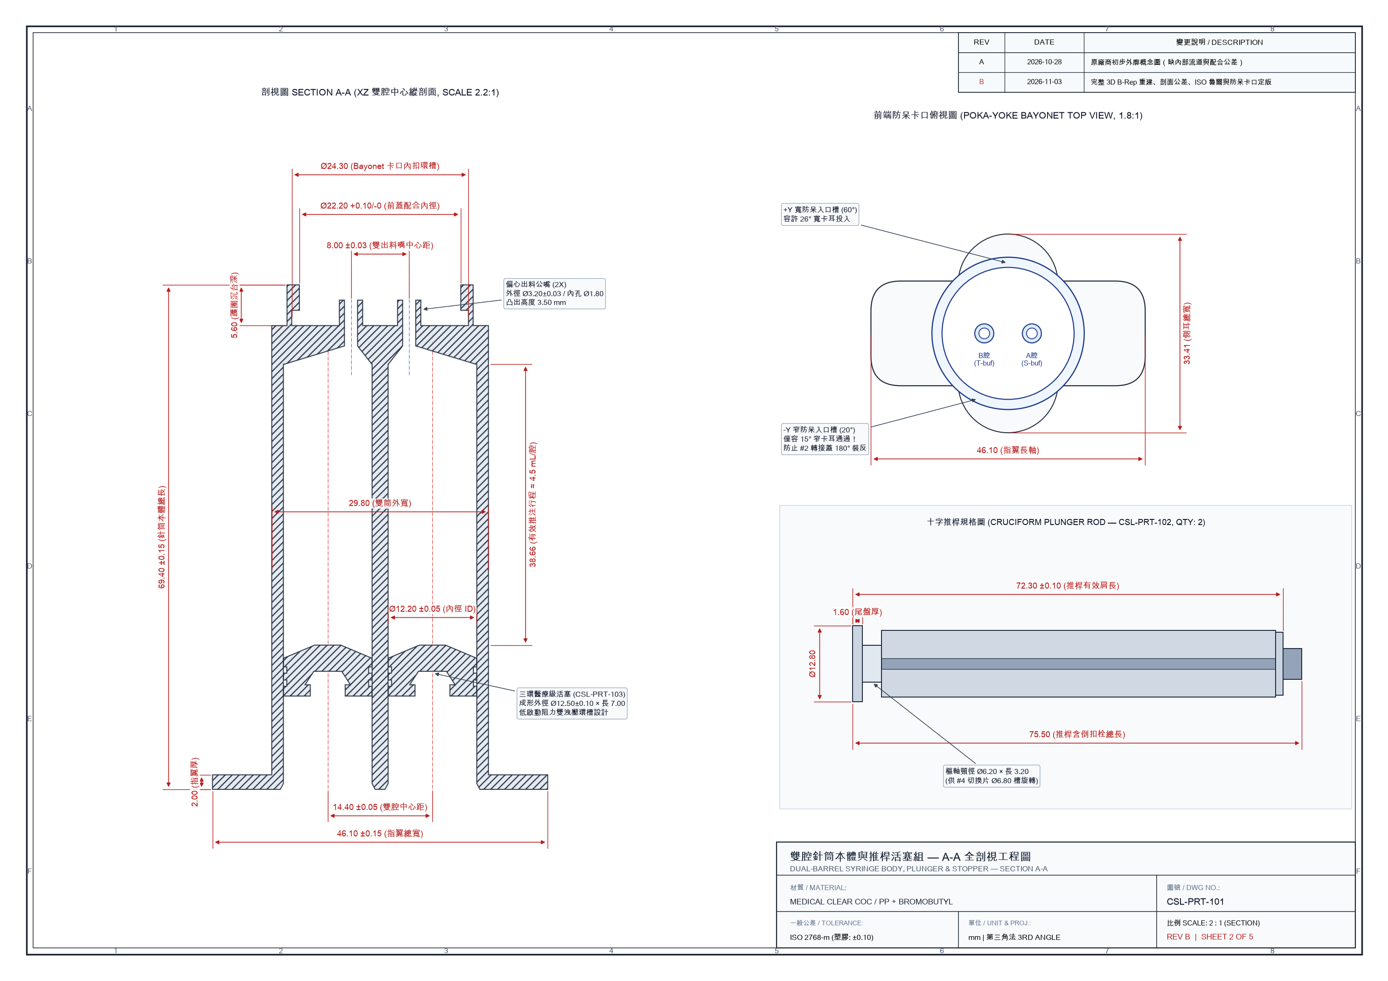
assets/sheets/sheet_2.png
