cybricks0025-tech/surgical-sealant/assets/sheets/sheet_3.png

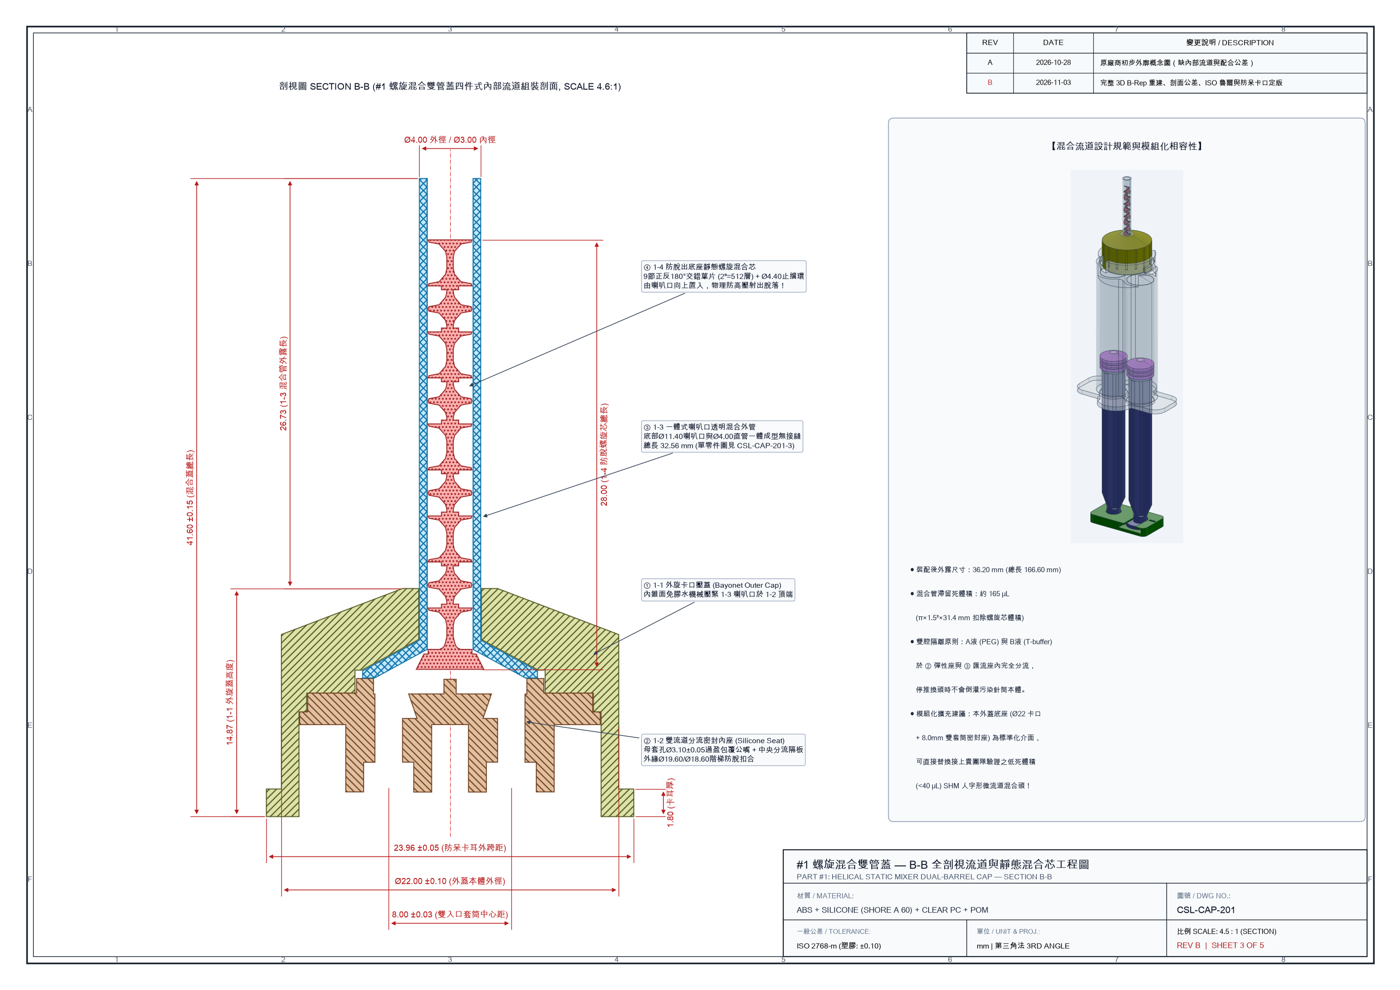
assets/sheets/sheet_3.png
