cybricks0025-tech/surgical-sealant/assets/sheets/sheet_4.png

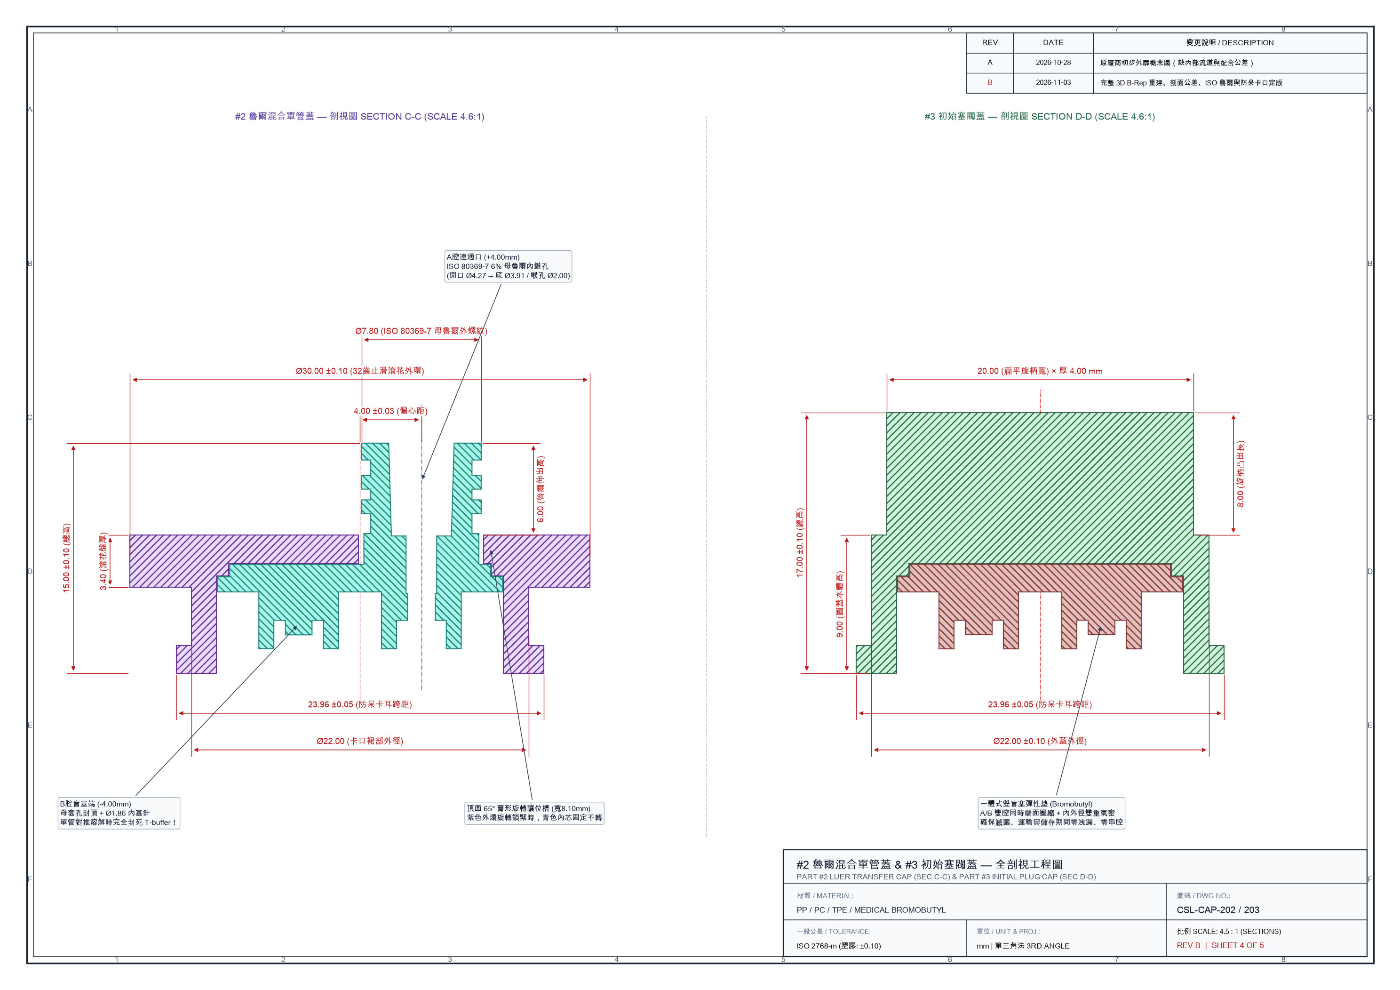
assets/sheets/sheet_4.png
