cybricks0025-tech/surgical-sealant/assets/sheets/sheet_5.png

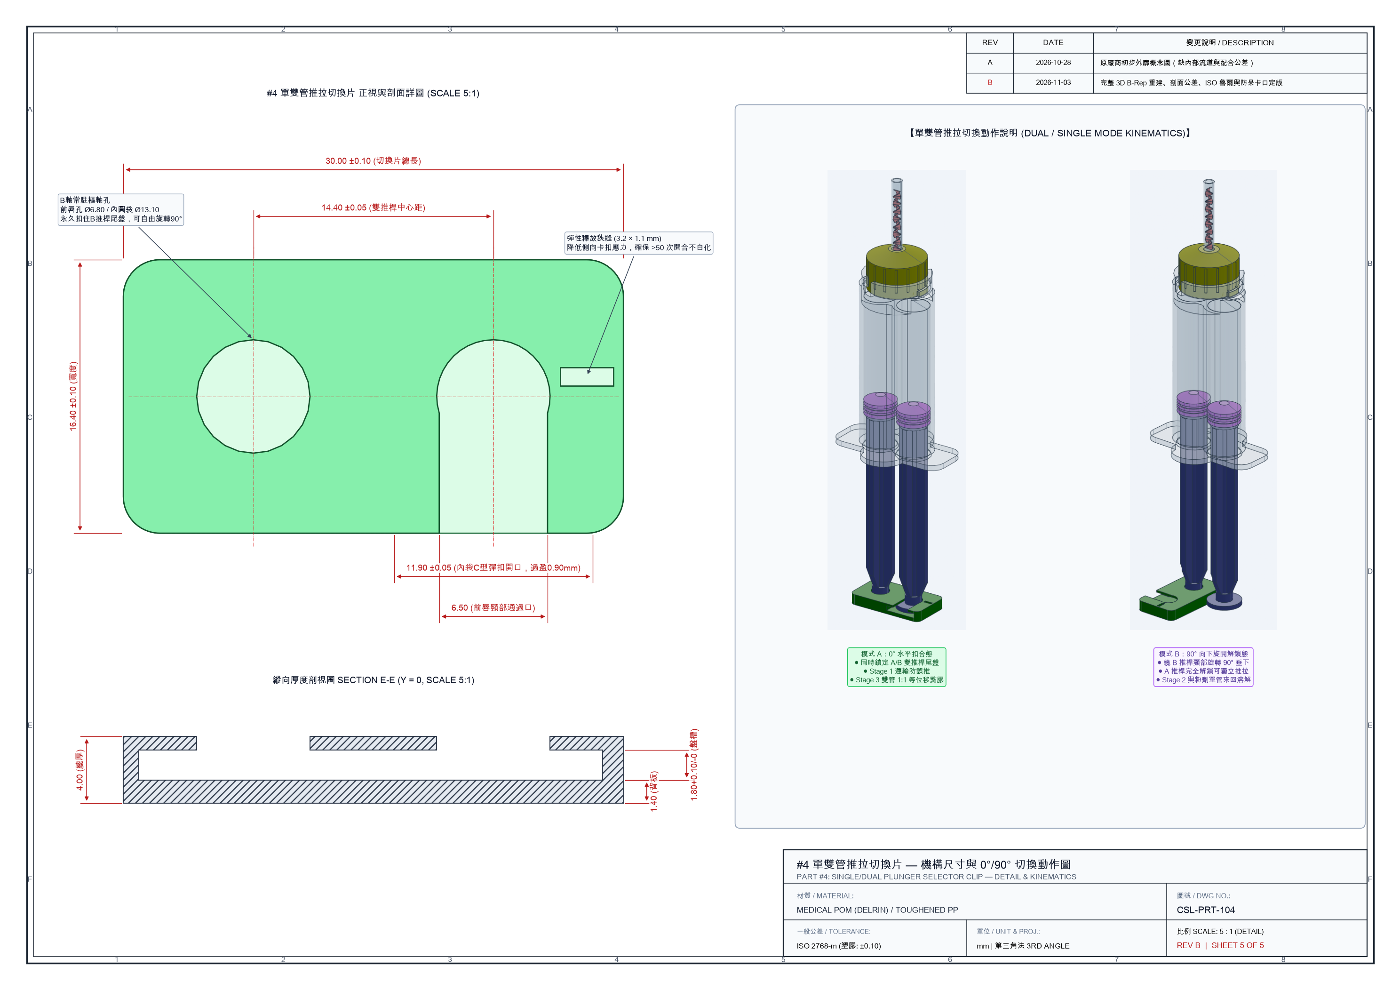
assets/sheets/sheet_5.png
