cybricks0025-tech/surgical-sealant/STEP/coseal_system_overview.step

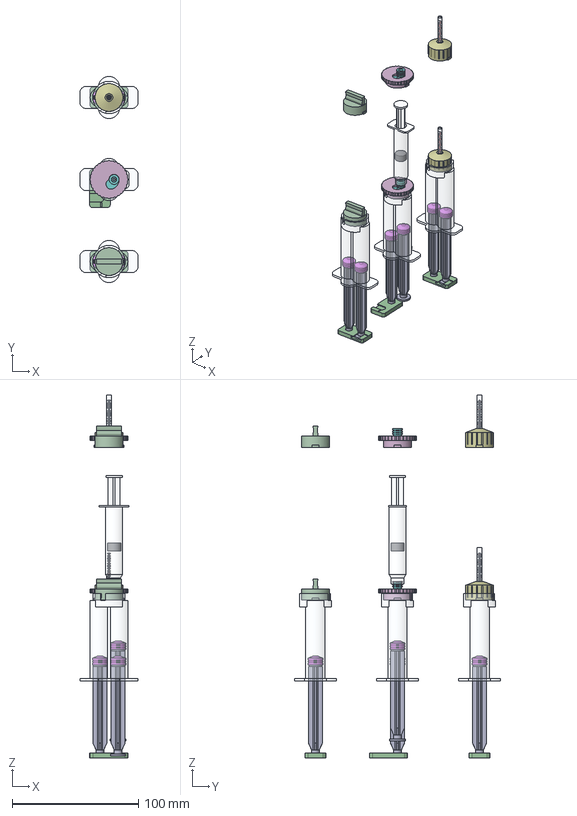
[picture p11: CAD file, 2026-11-04]
STEP/coseal_system_overview.step
46.1 x 163.4 x 287.6 mm
stage3_barrel x 2
stage3_plunger_a x 2
stage3_stopper_a x 2
stage3_plunger_b x 2
stage3_stopper_b x 2
stage3_clip x 2
plug_outer_cap x 2
dual_blind_plug x 2
stage2_barrel
stage2_plunger_b x 2
stage2_stopper_b x 2
stage2_clip
luer_outer_ring x 2
eccentric_luer_insert x 2
powder_syringe_barrel
powder_stopper
powder_plunger
part1_outer_cap x 2
part2_seal_seat x 2
part3_bell_cannula x 2
part4_helical_core x 2
