cybricks0025-tech/surgical-sealant/STEP/coseal_device_dispense.step

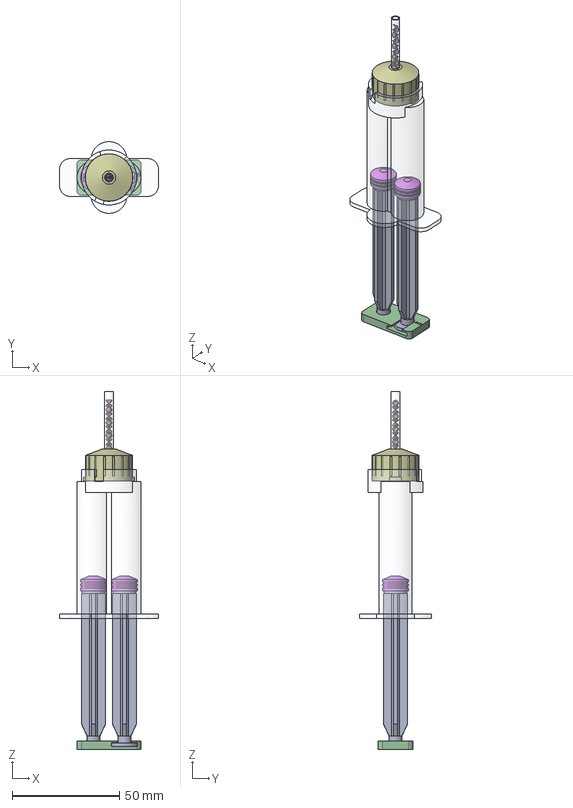
[picture p12: CAD file, 2026-11-04]
STEP/coseal_device_dispense.step
46.1 x 33.4 x 166.6 mm
barrel
plunger_b x 2
stopper_b x 2
selector_clip
part1_outer_cap
part2_seal_seat
part3_bell_cannula
part4_helical_core
