cybricks0025-tech/surgical-sealant/STEP/helical_mixer_cap.step

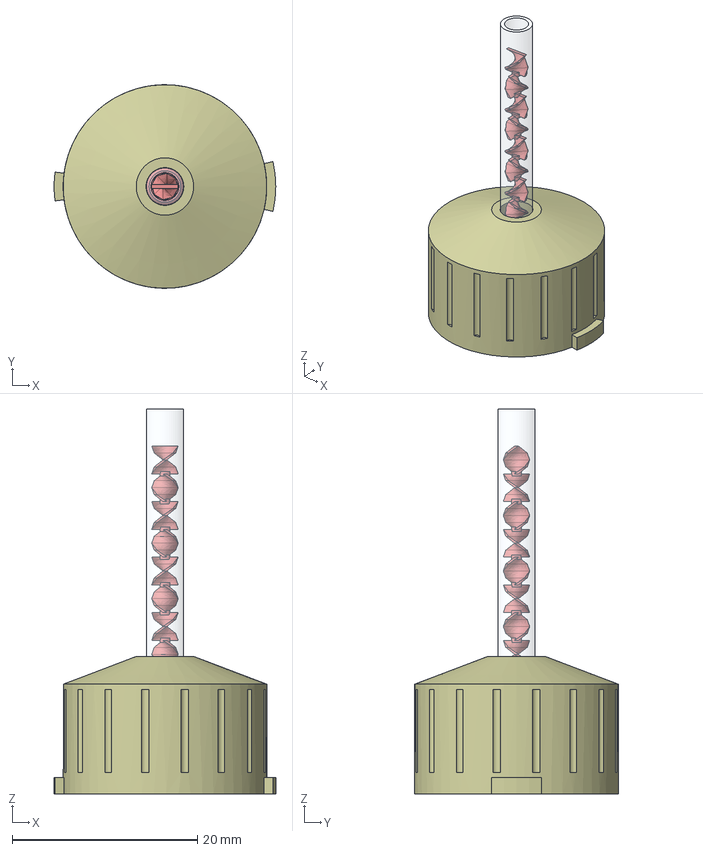
[picture p13: CAD file, 2026-11-04]
STEP/helical_mixer_cap.step
23.9 x 22.0 x 41.6 mm
part1_outer_cap
part2_seal_seat
part3_bell_cannula
part4_helical_core
