cybricks0025-tech/surgical-sealant/STEP/mixer_part3_bell_cannula.step

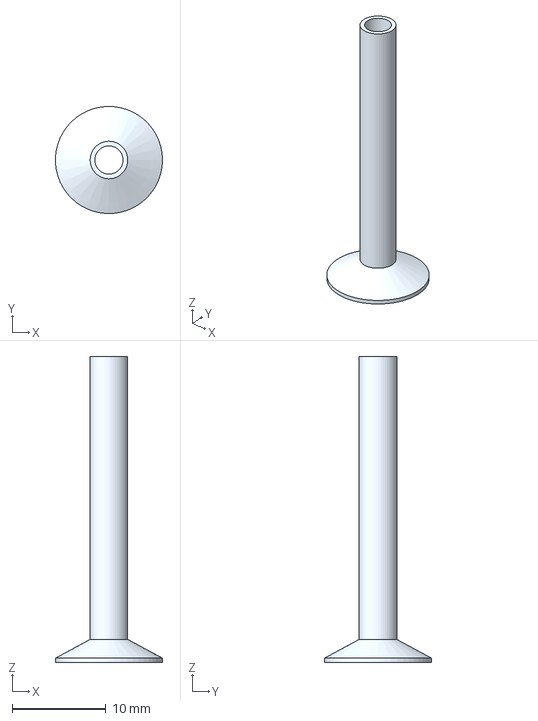
[picture p14: CAD file, 2026-11-04]
STEP/mixer_part3_bell_cannula.step
11.4 x 11.4 x 32.6 mm
