cybricks0025-tech/surgical-sealant/STEP/mixer_4part_exploded.step

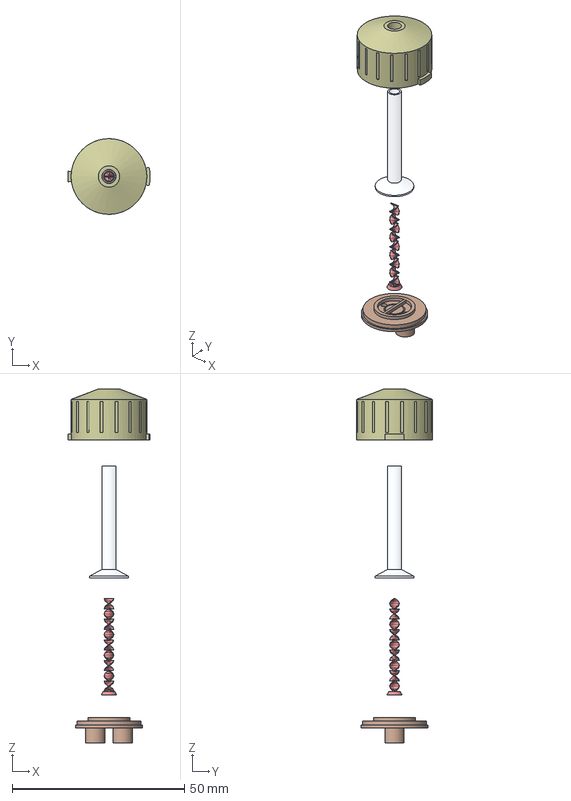
[picture p15: CAD file, 2026-11-04]
STEP/mixer_4part_exploded.step
23.9 x 22.0 x 102.9 mm
part1_outer_cap
part3_bell_cannula
part4_helical_core
part2_seal_seat
