cybricks0025-tech/surgical-sealant/STEP/mixer_part2_seal_seat.step

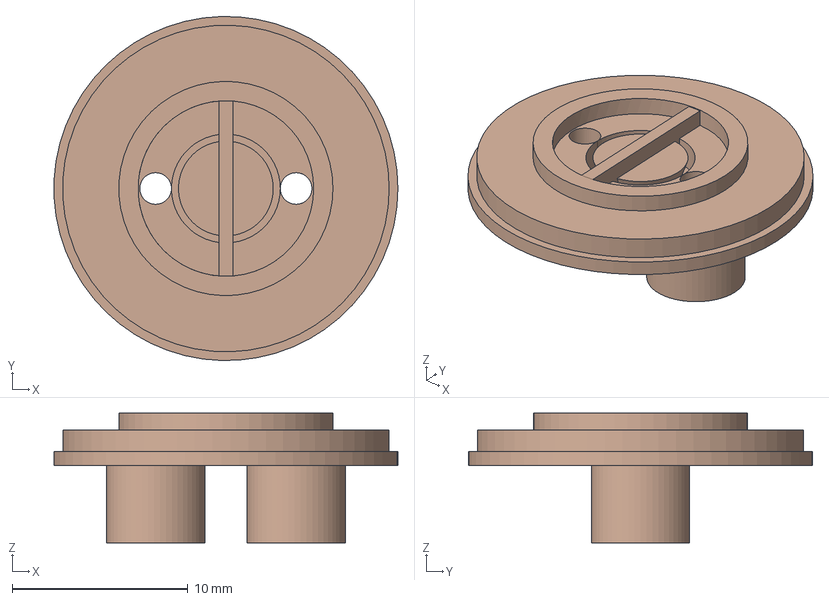
[picture p16: CAD file, 2026-11-04]
STEP/mixer_part2_seal_seat.step
19.6 x 19.6 x 7.40 mm
