cybricks0025-tech/surgical-sealant/STEP/mixer_part4_helical_core.step

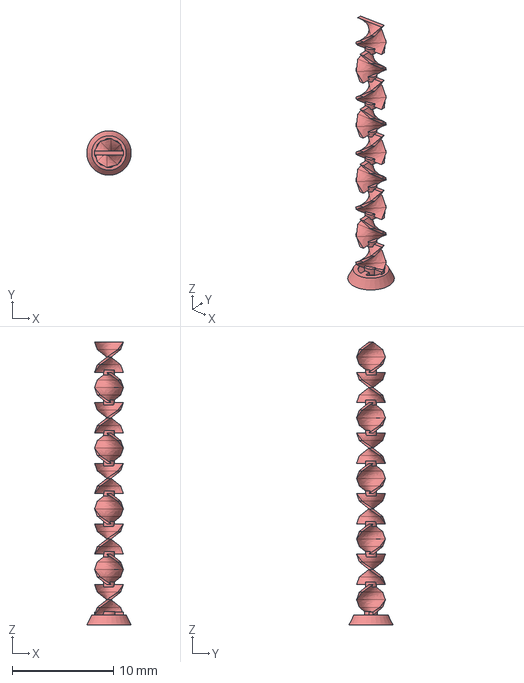
[picture p17: CAD file, 2026-11-04]
STEP/mixer_part4_helical_core.step
4.40 x 4.40 x 28.0 mm
