cybricks0025-tech/surgical-sealant/STEP/mixer_part1_outer_cap.step

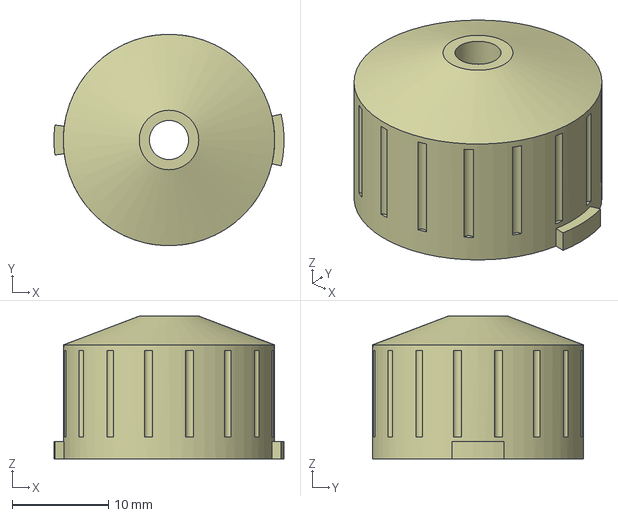
[picture p18: CAD file, 2026-11-04]
STEP/mixer_part1_outer_cap.step
23.9 x 22.0 x 14.9 mm
