cybricks0025-tech/surgical-sealant/STEP/powder_syringe.step

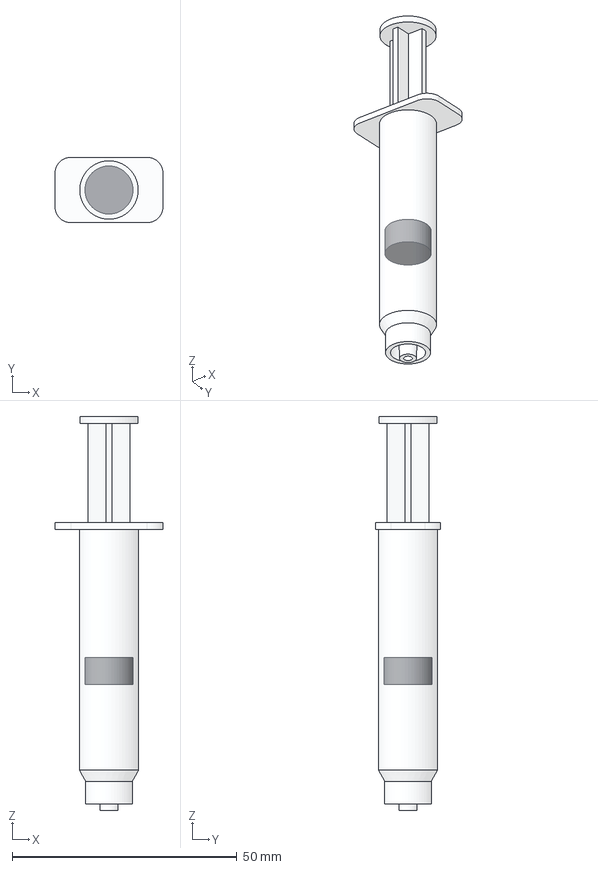
[picture p19: CAD file, 2026-11-03]
STEP/powder_syringe.step
24.0 x 14.5 x 87.6 mm
powder_syringe_barrel
powder_stopper
powder_plunger
