cybricks0025-tech/surgical-sealant/STEP/initial_plug_cap.step

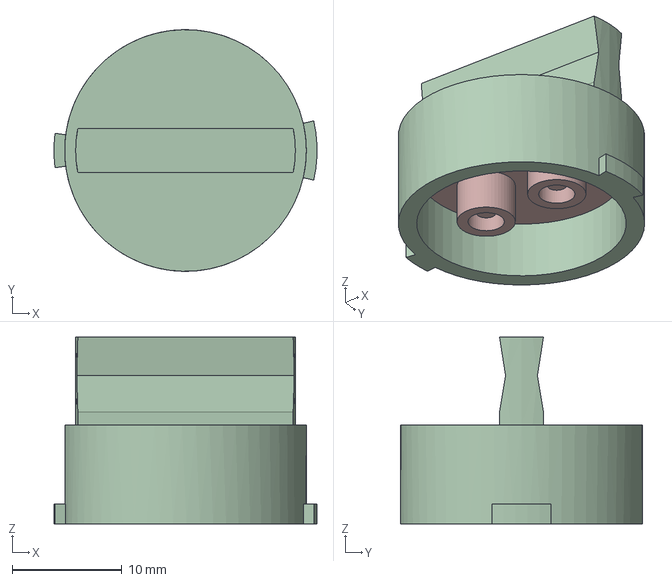
[picture p20: CAD file, 2026-11-03]
STEP/initial_plug_cap.step
23.9 x 22.0 x 17.0 mm
plug_outer_cap
dual_blind_plug
