cybricks0025-tech/surgical-sealant/STEP/elastomer_stopper.step

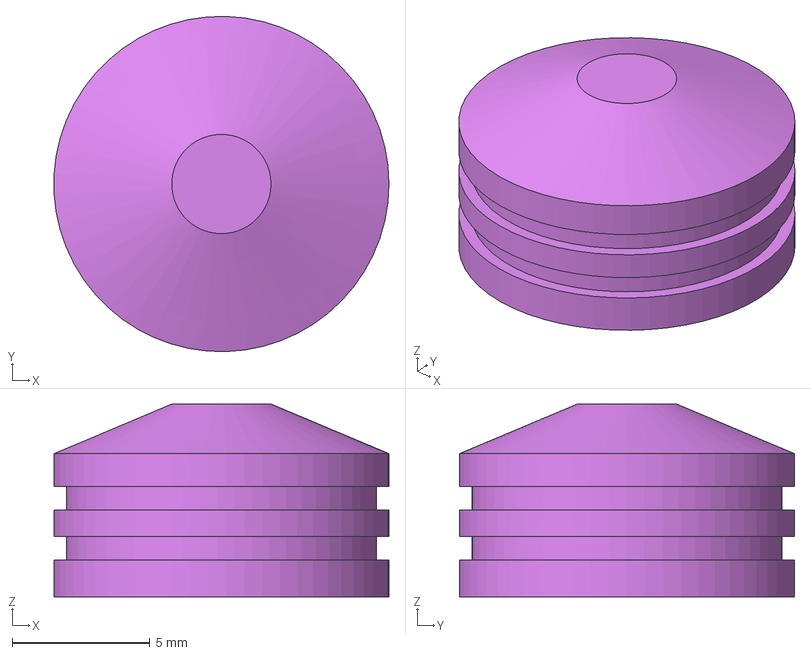
[picture p21: CAD file, 2026-11-03]
STEP/elastomer_stopper.step
12.2 x 12.2 x 7.00 mm
