cybricks0025-tech/surgical-sealant/STEP/plunger_rod.step

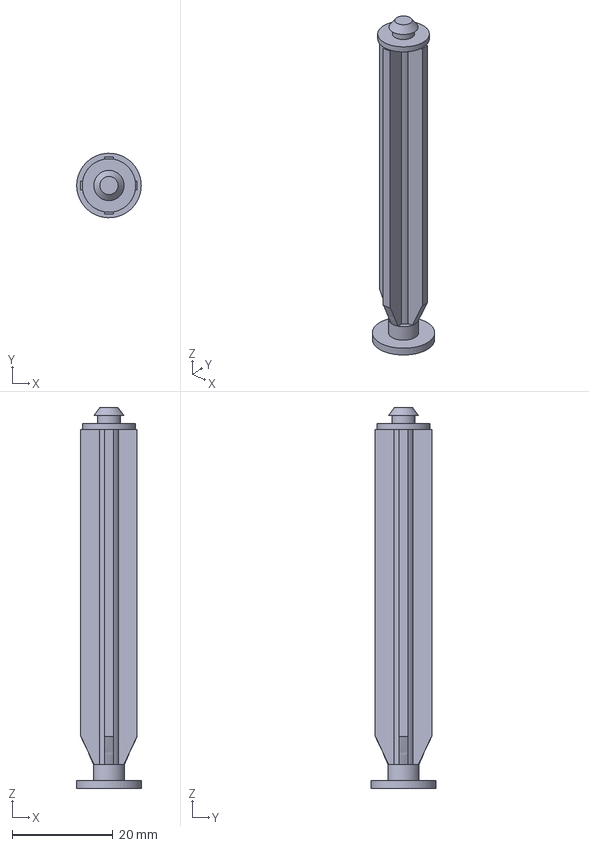
[picture p22: CAD file, 2026-11-03]
STEP/plunger_rod.step
12.8 x 12.8 x 75.5 mm
