cybricks0025-tech/surgical-sealant/STEP/dual_barrel_body.step

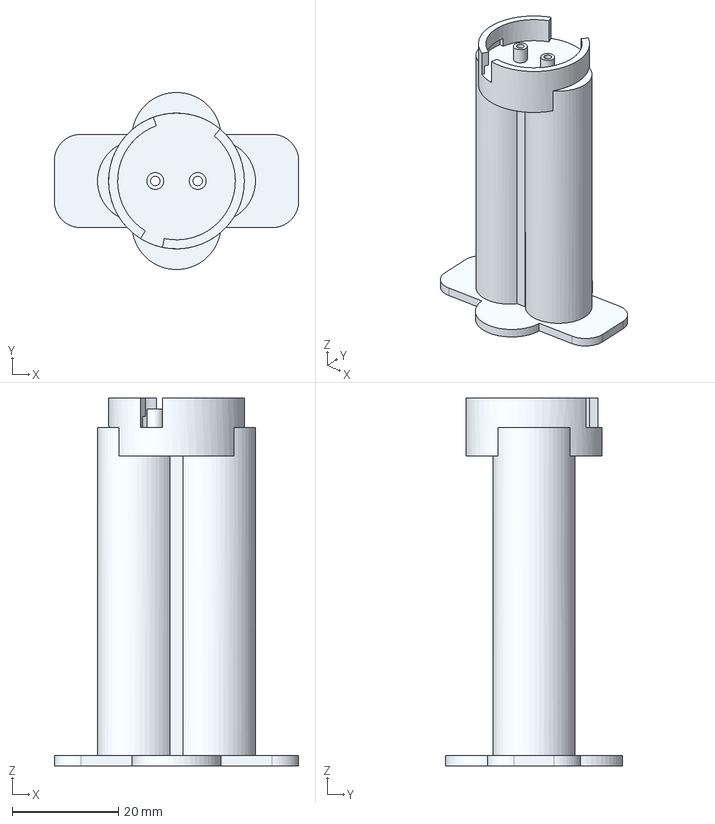
[picture p23: CAD file, 2026-11-03]
STEP/dual_barrel_body.step
46.1 x 33.4 x 69.4 mm
