cybricks0025-tech/surgical-sealant/STEP/luer_transfer_cap.step

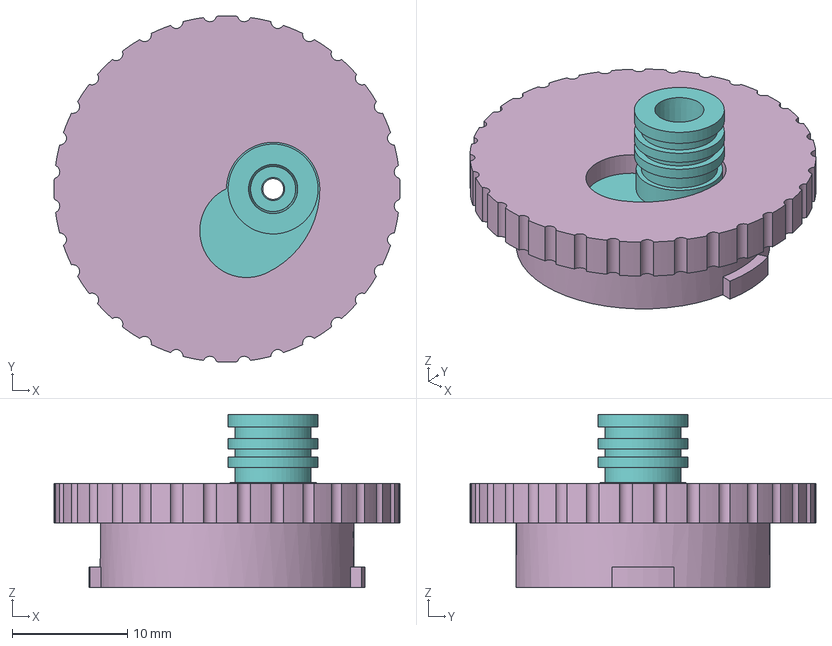
[picture p24: CAD file, 2026-11-03]
STEP/luer_transfer_cap.step
30.0 x 30.0 x 15.0 mm
luer_outer_ring
eccentric_luer_insert
