cybricks0025-tech/surgical-sealant/STEP/dual_syringe_holder.step

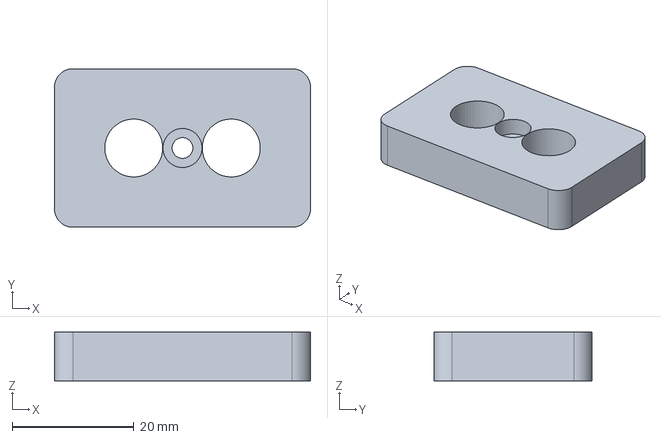
[picture p25: CAD file, 2026-11-03]
STEP/dual_syringe_holder.step
42.0 x 26.0 x 8.00 mm
