cybricks0025-tech/surgical-sealant/STEP/plunger_clip.step

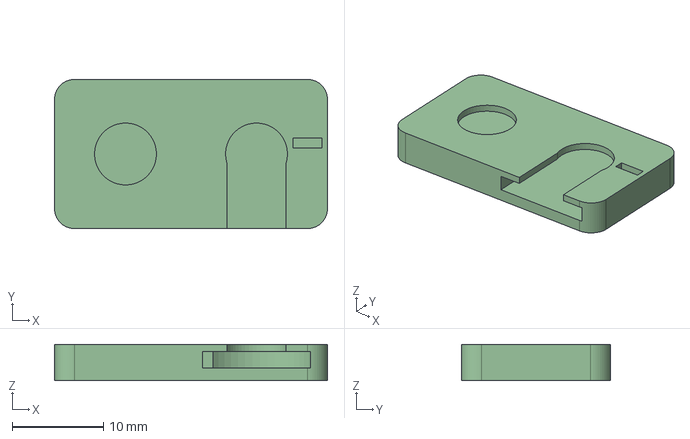
[picture p26: CAD file, 2026-11-03]
STEP/plunger_clip.step
30.0 x 16.4 x 4.00 mm
