cybricks0025-tech/surgical-sealant/(list of files, cad)

Other CAD files:
3MF/coseal_device_dispense.3mf
3MF/dual_syringe_holder.3mf
STL/coseal_device_dispense.stl
STL/dual_barrel_body.stl
STL/dual_syringe_holder.stl
STL/elastomer_stopper.stl
STL/helical_mixer_cap.stl
STL/initial_plug_cap.stl
STL/luer_transfer_cap.stl
STL/mixer_4part_exploded.stl
STL/mixer_part1_outer_cap.stl
STL/mixer_part2_seal_seat.stl
STL/mixer_part3_bell_cannula.stl
STL/mixer_part4_helical_core.stl
STL/plunger_clip.stl
STL/plunger_rod.stl
