cybricks0025-tech/surgical-sealant/PDF/雙單管混合裝置_完整專業設計圖_RevB.pdf

## 三階段操作組態與可替換前蓋 3D 總成視圖 (3-Stage Kit Isometric) 完整工程物料清單 (MASTER BILL OF MATERIALS — #1 混合頭四件式同步版)

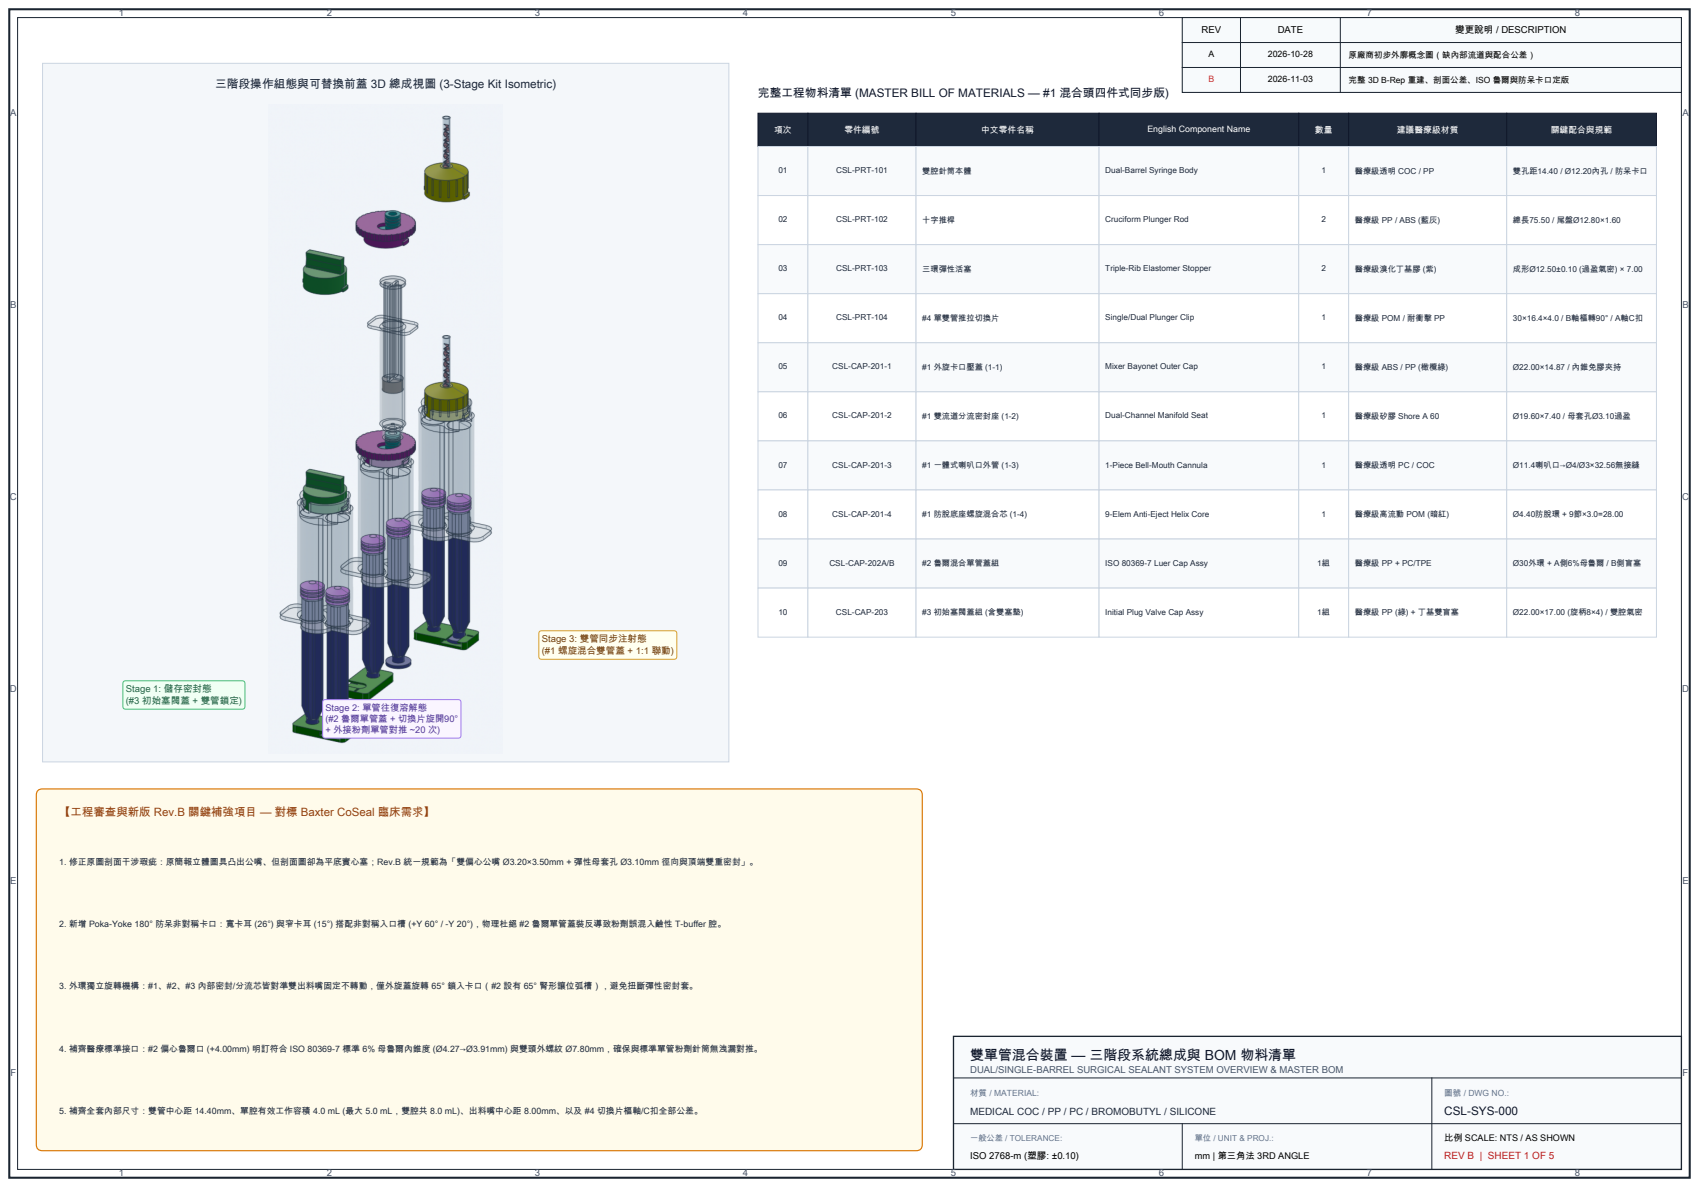
[picture p27: page 1]
Stage 1: 儲存密封態 (#3 初始塞閥蓋 + 雙管鎖定); Stage 2: 單管往復溶解態 (#2 魯爾單管蓋 + 切換片旋開90° + 外接粉劑單管對推 ~20 次); Stage 3: 雙管同步注射態 (#1 螺旋混合雙管蓋 + 1:1 聯動)

REV | DATE | 變更說明 / DESCRIPTION

A | 2026-10-28 | 原廠商初步外廓概念圖（缺內部流道與配合公差）

B | 2026-11-03 | 完整 3D B-Rep 重建、剖面公差、ISO 魯爾與防呆卡口定版

項次 | 零件編號 | 中文零件名稱 | English Component Name | 數量 | 建議醫療級材質 | 關鍵配合與規範

01 | CSL-PRT-101 | 雙腔針筒本體 | Dual-Barrel Syringe Body | 1 | 醫療級透明 COC / PP | 雙孔距14.40 / Ø12.20內孔 / 防呆卡口

02 | CSL-PRT-102 | 十字推桿 | Cruciform Plunger Rod | 2 | 醫療級 PP / ABS (藍灰) | 總長75.50 / 尾盤Ø12.80×1.60

03 | CSL-PRT-103 | 三環彈性活塞 | Triple-Rib Elastomer Stopper | 2 | 醫療級溴化丁基膠 (紫) | 成形Ø12.50±0.10 (過盈氣密) × 7.00

04 | CSL-PRT-104 | #4 單雙管推拉切換片 | Single/Dual Plunger Clip | 1 | 醫療級 POM / 耐衝擊 PP | 30×16.4×4.0 / B軸樞轉90° / A軸C扣

05 | CSL-CAP-201-1 | #1 外旋卡口壓蓋 (1-1) | Mixer Bayonet Outer Cap | 1 | 醫療級 ABS / PP (橄欖綠) | Ø22.00×14.87 / 內錐免膠夾持

06 | CSL-CAP-201-2 | #1 雙流道分流密封座 (1-2) | Dual-Channel Manifold Seat | 1 | 醫療級矽膠 Shore A 60 | Ø19.60×7.40 / 母套孔Ø3.10過盈

07 | CSL-CAP-201-3 | #1 一體式喇叭口外管 (1-3) | 1-Piece Bell-Mouth Cannula | 1 | 醫療級透明 PC / COC | Ø11.4喇叭口→Ø4/Ø3×32.56無接縫

08 | CSL-CAP-201-4 | #1 防脫底座螺旋混合芯 (1-4) | 9-Elem Anti-Eject Helix Core | 1 | 醫療級高流動 POM (暗紅) | Ø4.40防脫環 + 9節×3.0=28.00

09 | CSL-CAP-202A/B | #2 魯爾混合單管蓋組 | ISO 80369-7 Luer Cap Assy | 1組 | 醫療級 PP + PC/TPE | Ø30外環 + A側6%母魯爾 / B側盲塞

10 | CSL-CAP-203 | #3 初始塞閥蓋組 (含雙塞墊) | Initial Plug Valve Cap Assy | 1組 | 醫療級 PP (綠) + 丁基雙盲塞 | Ø22.00×17.00 (旋柄8×4) / 雙腔氣密

【工程審查與新版 Rev.B 關鍵補強項目 — 對標 Baxter CoSeal 臨床需求】

1. 修正原圖剖面干涉瑕疵：原簡報立體圖具凸出公嘴、但剖面圖卻為平底實心塞；Rev.B 統一規範為「雙偏心公嘴 Ø3.20×3.50mm + 彈性母套孔 Ø3.10mm 徑向與頂端雙重密封」。

2. 新增 Poka-Yoke 180° 防呆非對稱卡口：寬卡耳 (26°) 與窄卡耳 (15°) 搭配非對稱入口槽 (+Y 60° / -Y 20°)，物理杜絕 #2 魯爾單管蓋裝反導致粉劑誤混入鹼性 T-buffer 腔。

3. 外環獨立旋轉機構：#1、#2、#3 內部密封/分流芯皆對準雙出料嘴固定不轉動，僅外旋蓋旋轉 65° 鎖入卡口（#2 設有 65° 腎形讓位弧槽），避免扭斷彈性密封套。

4. 補齊醫療標準接口：#2 偏心魯爾口 (+4.00mm) 明訂符合 ISO 80369-7 標準 6% 母魯爾內錐度 (Ø4.27→Ø3.91mm) 與雙頭外螺紋 Ø7.80mm，確保與標準單管粉劑針筒無洩漏對推。

雙單管混合裝置 — 三階段系統總成與 BOM 物料清單
DUAL/SINGLE-BARREL SURGICAL SEALANT SYSTEM OVERVIEW & MASTER BOM

材質 / MATERIAL: MEDICAL COC / PP / PC / BROMOBUTYL / SILICONE | 圖號 / DWG NO.: CSL-SYS-000

5. 補齊全套內部尺寸：雙管中心距 14.40mm、單腔有效工作容積 4.0 mL (最大 5.0 mL，雙腔共 8.0 mL)、出料嘴中心距 8.00mm、以及 #4 切換片樞軸/C扣全部公差。

一般公差 / TOLERANCE: ISO 2768-m (塑膠: ±0.10) | 單位 / UNIT & PROJ.: mm | 第三角法 3RD ANGLE | 比例 SCALE: NTS / AS SHOWN REV B | SHEET 1 OF 5

## 剖視圖 SECTION A-A (XZ 雙腔中心縱剖面, SCALE 2.2:1)

## 前端防呆卡口俯視圖 (POKA-YOKE BAYONET TOP VIEW, 1.8:1)

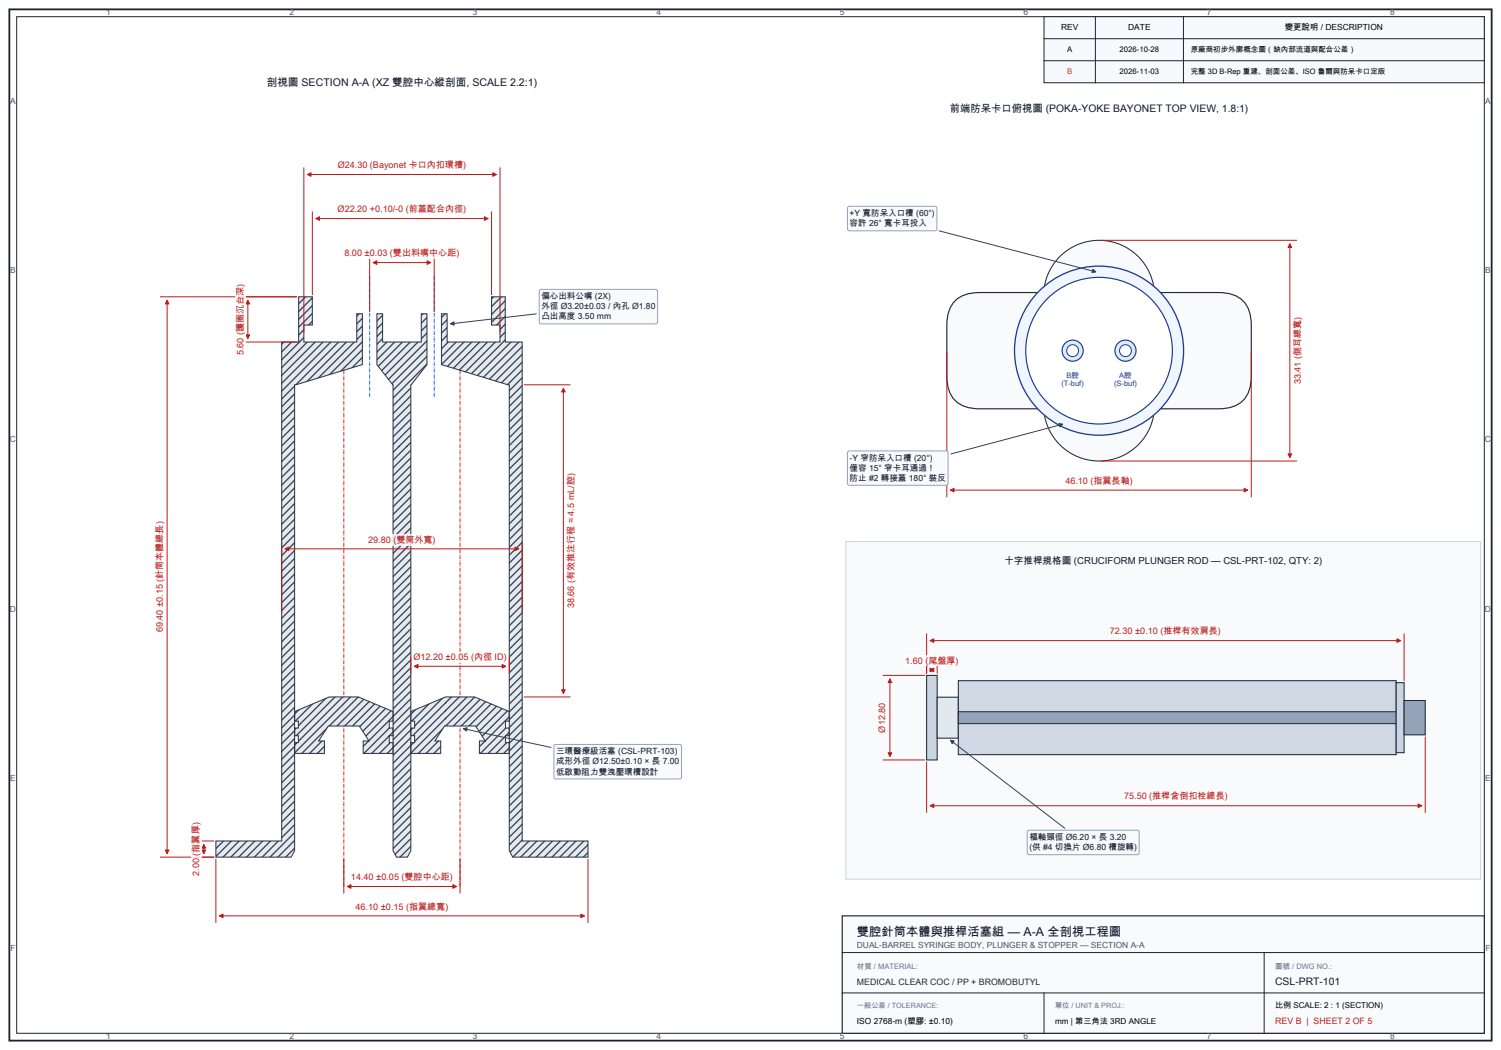
[picture p28: page 2]
B腔 (T-buf); A腔 (S-buf); 46.10 ±0.15 (指翼總寬); 29.80 (雙筒外寬); 14.40 ±0.05 (雙腔中心距); 8.00 ±0.03 (雙出料嘴中心距); Ø22.20 +0.10/-0 (前蓋配合內徑); Ø24.30 (Bayonet 卡口內扣環槽); 69.40 ±0.15 (針筒本體總長); 2.00 (指翼厚); 38.66 (有效推注; 5.60 (護圈沉台深); 46.10 (指翼長軸); 33.41 (側耳總寬); 72.30 ±0.10 (推桿有效肩長); 75.50 (推桿含倒扣栓總長); 1.60 (尾盤厚); 偏心出料公嘴 (2X) 外徑 Ø3.20±0.03 / 內孔 Ø1.80 凸出高度 3.50 mm; +Y 寬防呆入口槽 (60°) 容許 26° 寬卡耳投入; 樞軸頸徑 Ø6.20 × 長 3.20 (供 #4 切換片 Ø6.80 槽旋轉)

-Y 窄防呆入口槽 (20°)
僅容 15° 窄卡耳通過！
防止 #2 轉接蓋 180° 裝反

十字推桿規格圖 (CRUCIFORM PLUNGER ROD — CSL-PRT-102, QTY: 2)

三環醫療級活塞 (CSL-PRT-103)
成形外徑 Ø12.50±0.10 × 長 7.00
低啟動阻力雙洩壓環槽設計

雙腔針筒本體與推桿活塞組 — A-A 全剖視工程圖
DUAL-BARREL SYRINGE BODY, PLUNGER & STOPPER — SECTION A-A

材質 / MATERIAL:
MEDICAL CLEAR COC / PP + BROMOBUTYL

圖號 / DWG NO.:
CSL-PRT-101

比例 SCALE: 2 : 1 (SECTION)

## 剖視圖 SECTION B-B (#1 螺旋混合雙管蓋四件式內部流道組裝剖面, SCALE 4.6:1)

## 【混合流道設計規範與模組化相容性】

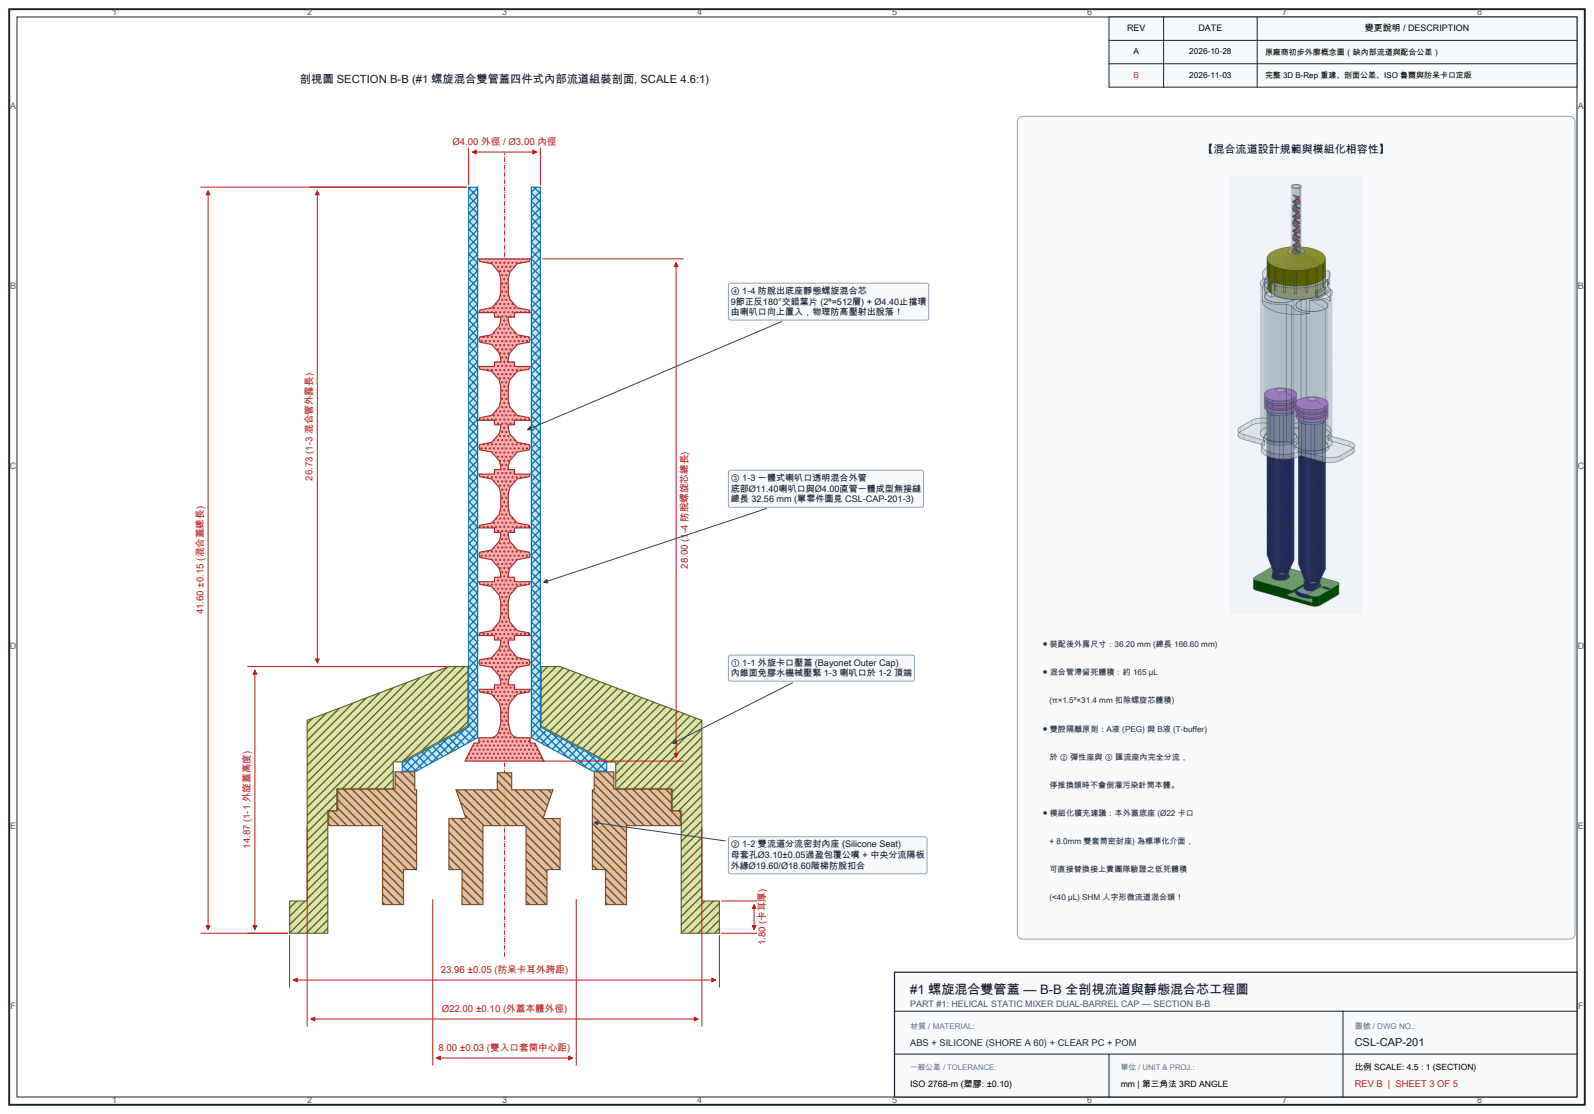
[picture p29: page 3]
● 混合管滯留死體積：約 165 µL; (π×1.5²×31.4 mm 扣除螺旋芯體積); 於 ② 彈性座與 ③ 匯流座內完全分流，; 停推換頭時不會倒灌污染針筒本體。; + 8.0mm 雙套筒密封座) 為標準化介面，; 可直接替換接上貴團隊驗證之低死體積; 41.60 ±0.15 (混合蓋總長); 14.87 (1-1 外旋蓋高; 26.73 (1-3 混合管外; 28.00 (1-4 防脫螺旋芯總長); 23.96 ±0.05 (防呆卡耳外跨距); Ø22.00 ±0.10 (外蓋本體外徑); 8.00 ±0.03 (雙入口套筒中心距); ④ 1-4 防脫出底座靜態螺旋混合芯 9節正反180°交錯葉片 (2⁹=512層) + Ø4.40止擋環 由喇叭口向上置入，物理防高壓射出脫落！; ② 1-2 雙流道分流密封內座 (Silicone Seat) 母套孔Ø3.10±0.05過盈包覆公嘴 + 中央分流隔板 外緣Ø19.60/Ø18.60階梯防脫扣合

③ 1-3 一體式喇叭口透明混合外管
底部Ø11.40喇叭口與Ø4.00直管一體成型無接縫
總長 32.56 mm (單零件圖見 CSL-CAP-201-3)

● 裝配後外露尺寸：36.20 mm (總長 166.60 mm)

① 1-1 外旋卡口壓蓋 (Bayonet Outer Cap)
內錐面免膠水機械壓緊 1-3 喇叭口於 1-2 頂端

● 雙腔隔離原則：A液 (PEG) 與 B液 (T-buffer)

● 模組化擴充建議：本外蓋底座 (Ø22 卡口

(<40 µL) SHM 人字形微流道混合頭！

#1 螺旋混合雙管蓋 — B-B 全剖視流道與靜態混合芯工程圖
PART #1: HELICAL STATIC MIXER DUAL-BARREL CAP — SECTION B-B

材質 / MATERIAL:
ABS + SILICONE (SHORE A 60) + CLEAR PC + POM

圖號 / DWG NO.:
CSL-CAP-201

比例 SCALE: 4.5 : 1 (SECTION)

#2 魯爾混合單管蓋 — 剖視圖 SECTION C-C (SCALE 4.6:1) | #3 初始塞閥蓋 — 剖視圖 SECTION D-D (SCALE 4.6:1)

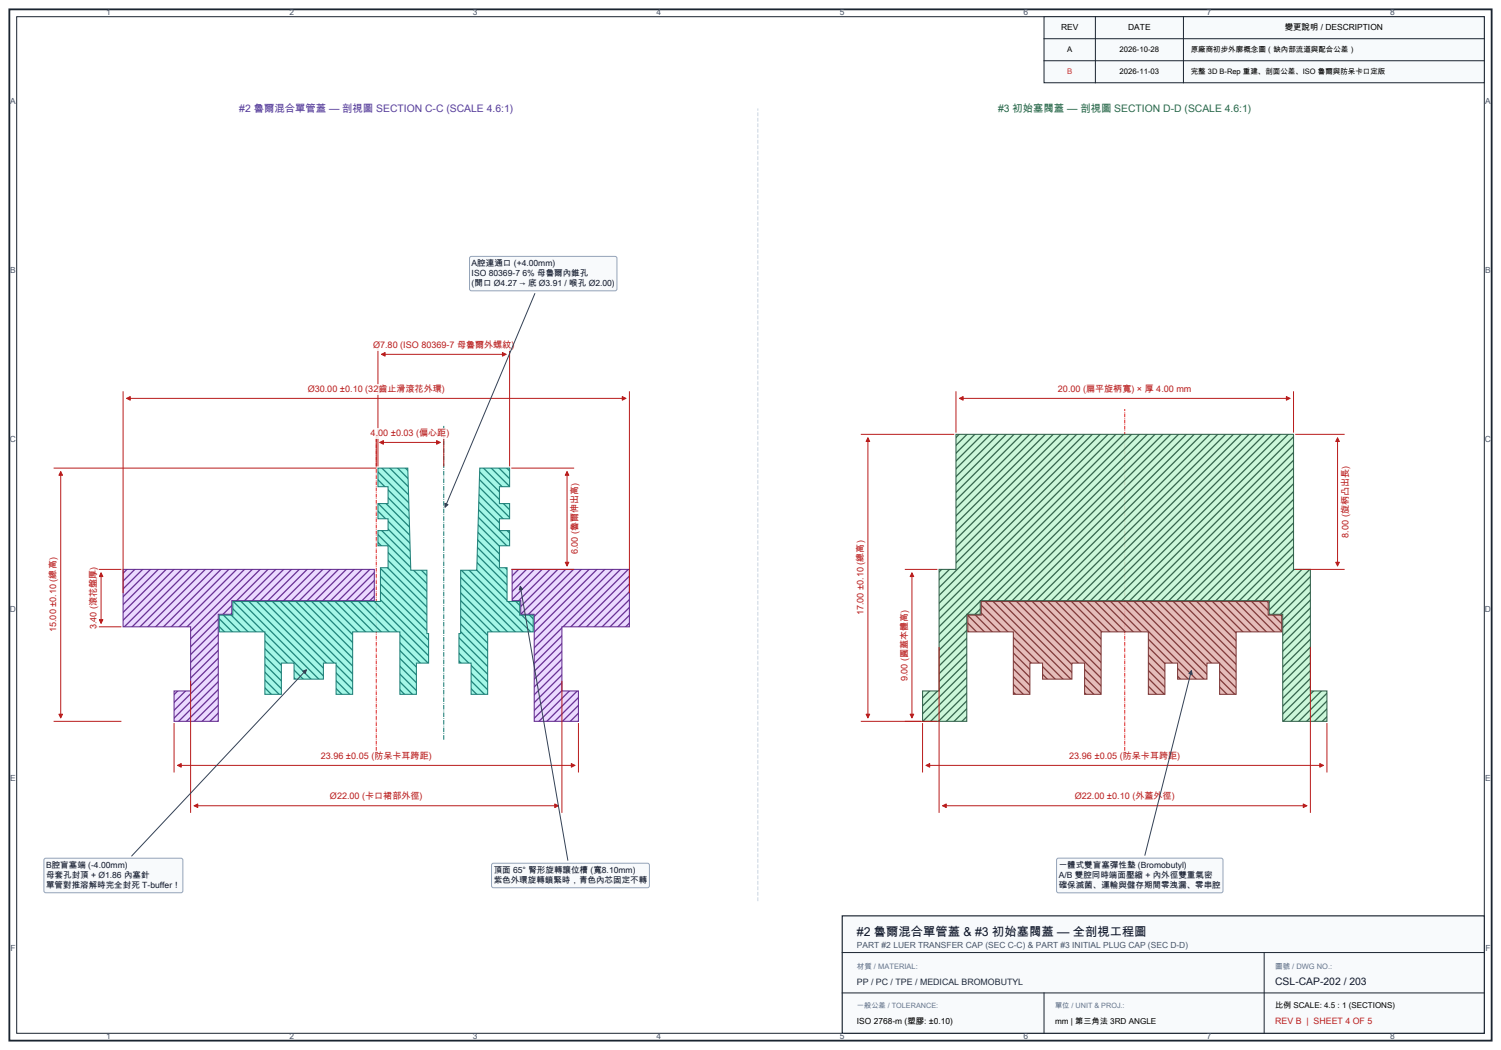
[picture p30: page 4]
Ø30.00 ±0.10 (32齒止滑滾花外環); 23.96 ±0.05 (防呆卡耳跨距); Ø22.00 (卡口裙部外徑); 4.00 ±0.03 (偏心距); Ø7.80 (ISO 80369-7 母魯爾外螺紋); 伸出高); Ø22.00 ±0.10 (外蓋外徑); 20.00 (扁平旋柄寬) × 厚 4.00 mm; 圓蓋本體高); 8.00 (旋柄凸出長); A腔連通口 (+4.00mm) ISO 80369-7 6% 母魯爾內錐孔 (開口 Ø4.27 → 底 Ø3.91 / 喉孔 Ø2.00); B腔盲塞端 (-4.00mm) 母套孔封頂 + Ø1.86 內塞針 單管對推溶解時完全封死 T-buffer！; 頂面 65° 腎形旋轉讓位槽 (寬8.10mm) 紫色外環旋轉鎖緊時，青色內芯固定不轉

一體式雙盲塞彈性墊 (Bromobutyl)
A/B 雙腔同時端面壓縮 + 內外徑雙重氣密
確保滅菌、運輸與儲存期間零洩漏、零串腔

#2 魯爾混合單管蓋 & #3 初始塞閥蓋 — 全剖視工程圖
PART #2 LUER TRANSFER CAP (SEC C-C) & PART #3 INITIAL PLUG CAP (SEC D-D)

材質 / MATERIAL:
PP / PC / TPE / MEDICAL BROMOBUTYL

圖號 / DWG NO.:
CSL-CAP-202 / 203

比例 SCALE: 4.5 : 1 (SECTIONS)

## #4 單雙管推拉切換片 正視與剖面詳圖 (SCALE 5:1)

## 【單雙管推拉切換動作說明 (DUAL / SINGLE MODE KINEMATICS)】

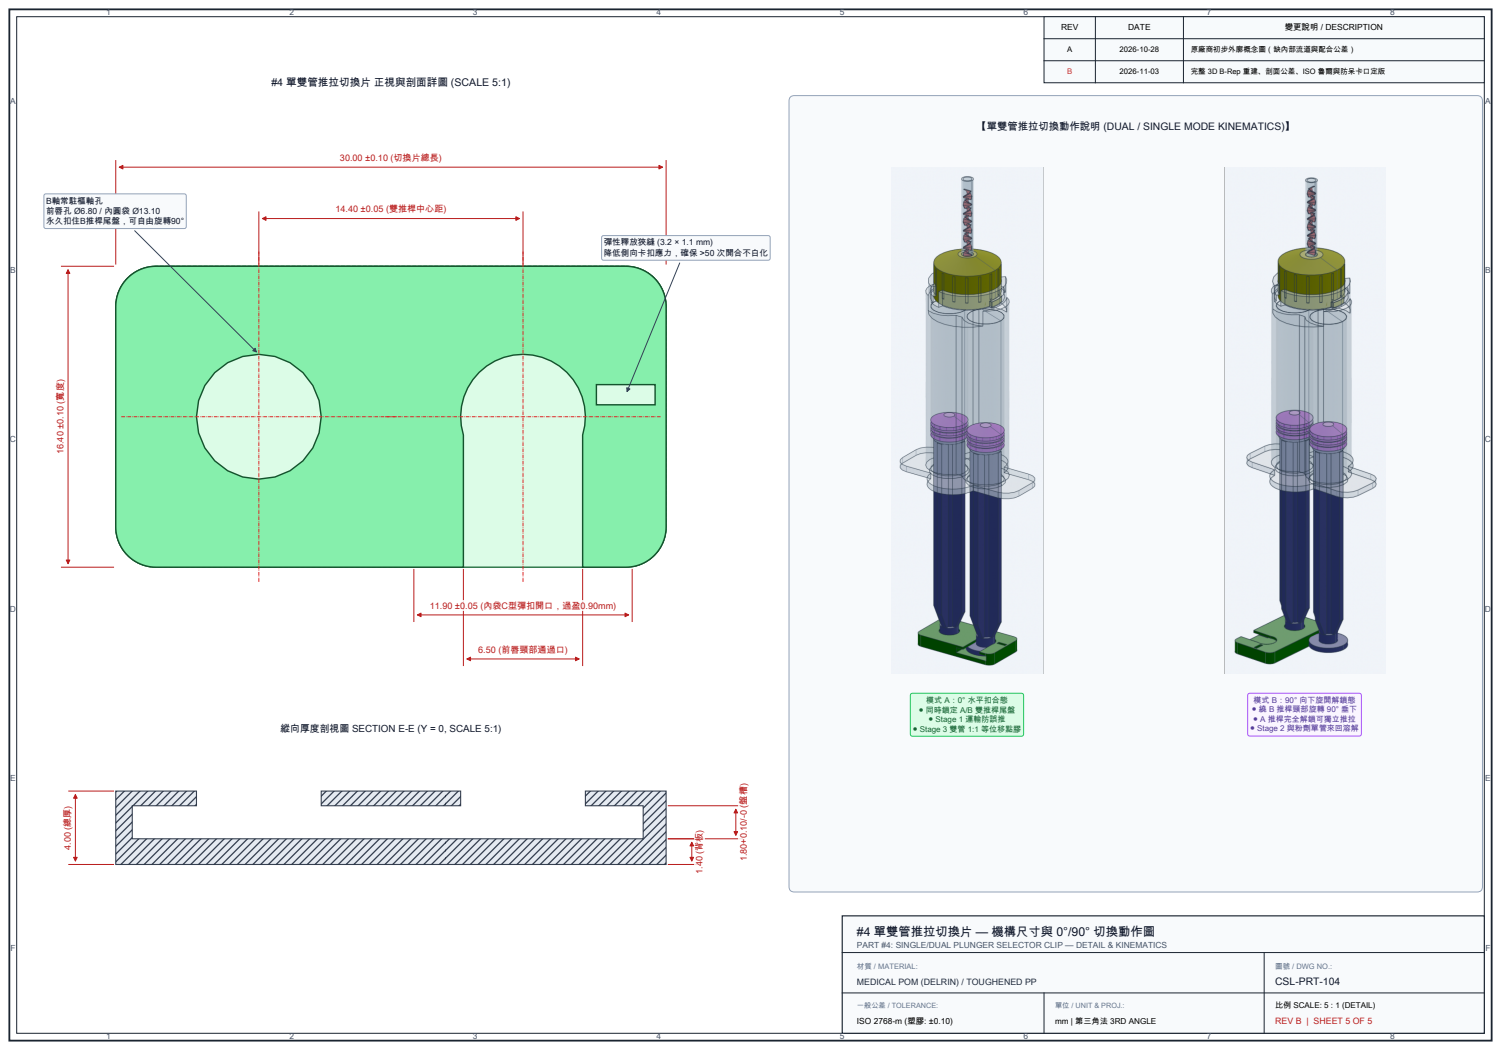
[picture p31: page 5]
模式 B：90° 向下旋開解鎖態 ● 繞 B 推桿頸部旋轉 90° 垂下 ● A 推桿完全解鎖可獨立推拉 ● Stage 2 與粉劑單管來回溶解; 30.00 ±0.10 (切換片總長); 14.40 ±0.05 (雙推桿中心距); 11.90 ±0.05 (內袋C型彈扣開口，過盈0.90mm); 6.50 (前唇頸部通過口); B軸常駐樞軸孔 前唇孔 Ø6.80 / 內圓袋 Ø13.10 永久扣住B推桿尾盤，可自由旋轉90°

彈性釋放狹縫 (3.2 × 1.1 mm)
降低側向卡扣應力，確保 >50 次開合不白化

模式 A：0° 水平扣合態
● 同時鎖定 A/B 雙推桿尾盤
● Stage 1 運輸防誤推
● Stage 3 雙管 1:1 等位移點膠

縱向厚度剖視圖 SECTION E-E (Y = 0, SCALE 5:1)

#4 單雙管推拉切換片 — 機構尺寸與 0°/90° 切換動作圖
PART #4: SINGLE/DUAL PLUNGER SELECTOR CLIP — DETAIL & KINEMATICS

材質 / MATERIAL:
MEDICAL POM (DELRIN) / TOUGHENED PP

圖號 / DWG NO.:
CSL-PRT-104

比例 SCALE: 5 : 1 (DETAIL)
