cybricks0025-tech/surgical-sealant/PDF/螺旋混合頭_四件式零件拆解設計圖_RevC.pdf

## 四件式組裝爆炸圖 (4-Part Rear-Loading Exploded)

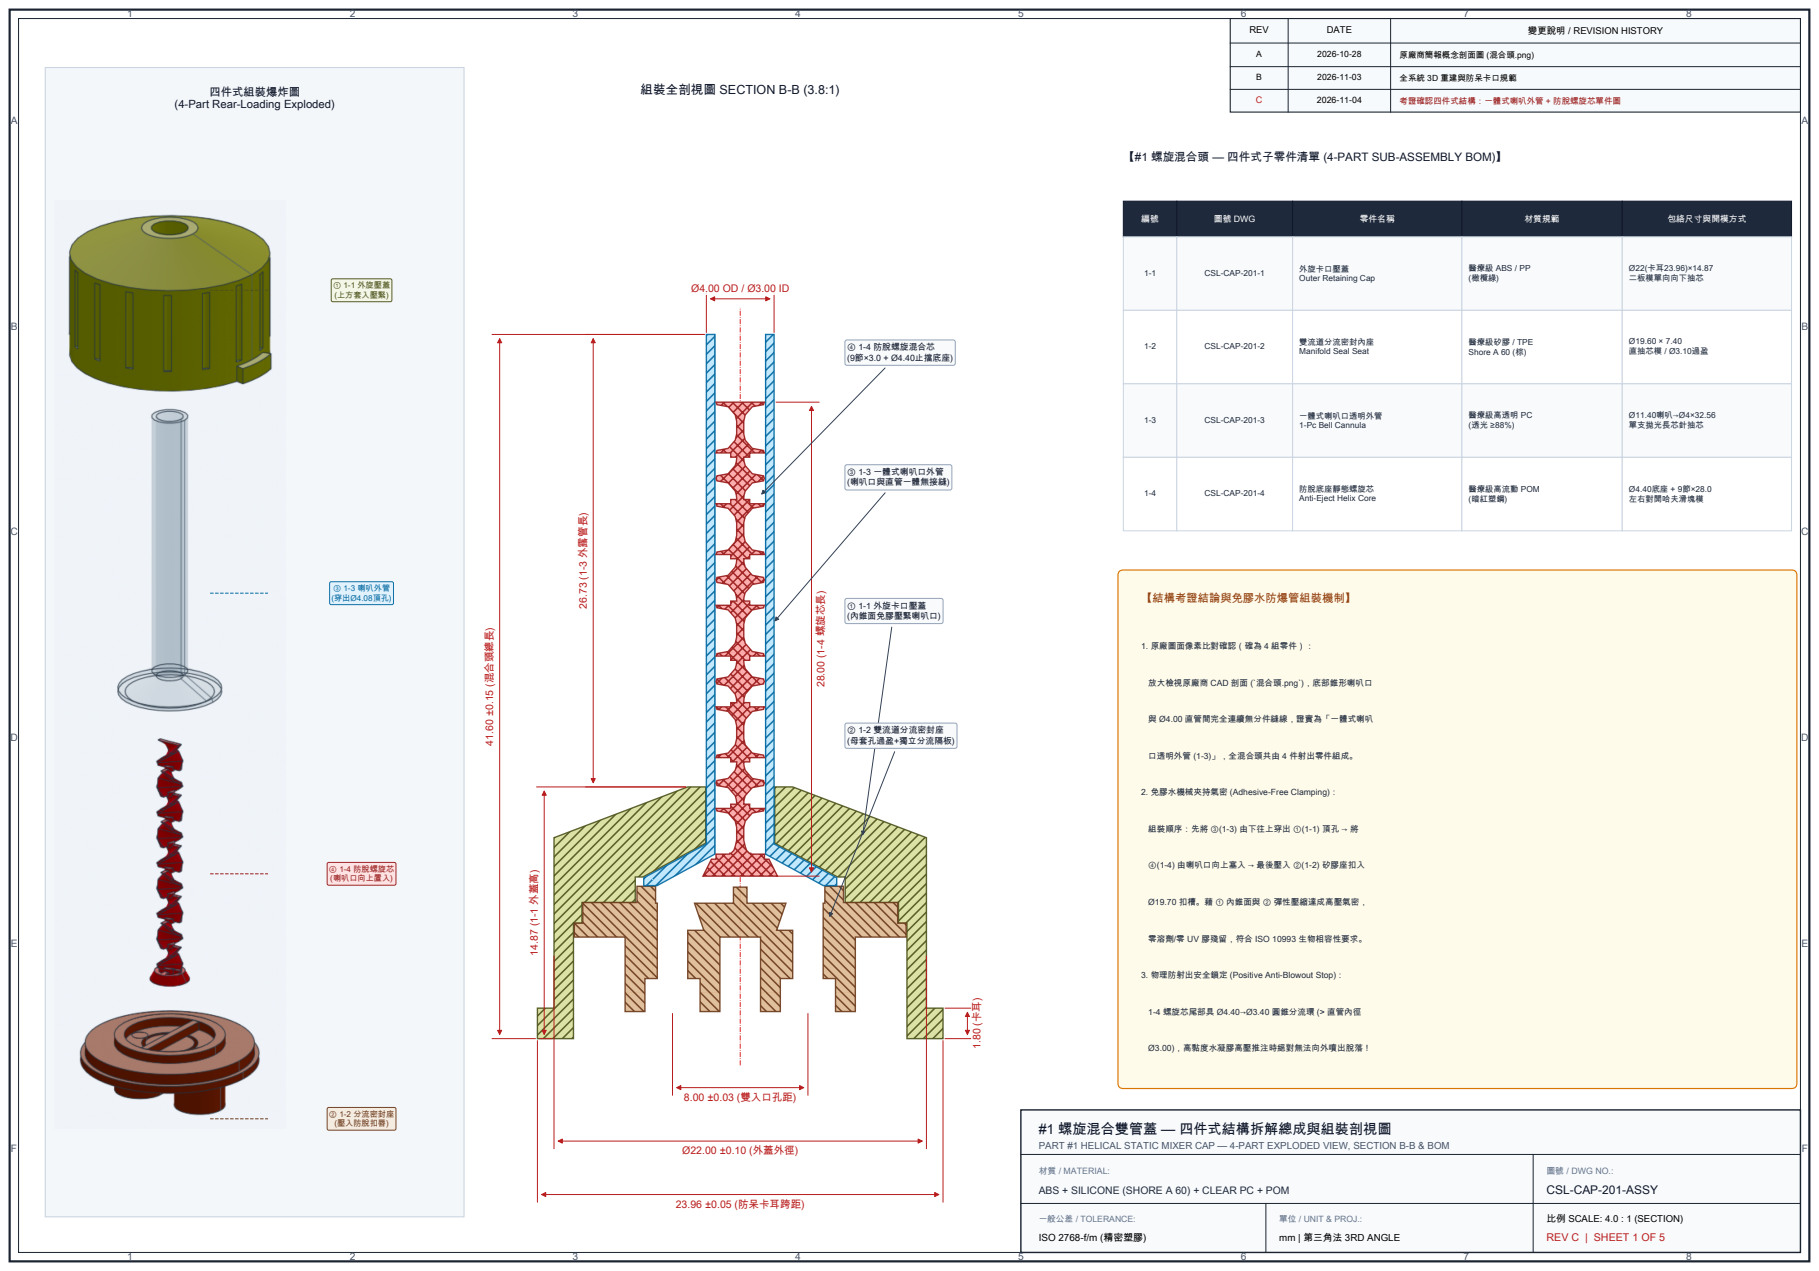
[picture p32: page 1]
REV; DATE; 變更說明 / REVISION HISTORY; 原廠商簡報概念剖面圖 (混合頭.png); 全系統 3D 重建與防呆卡口規範; 考證確認四件式結構：一體式喇叭外管 + 防脫螺旋芯單件圖; 一般公差 / TOLERANCE: ISO 2768-f/m (精密塑膠); 組裝全剖視圖 SECTION B-B (3.8:1); 圖號 DWG; 零件名稱; 材質規範; 包絡尺寸與開模方式; CSL-CAP-201-1; 外旋卡口壓蓋; Ø22(卡耳23.96)×14.87 二板模單向向下抽芯; CSL-CAP-201-2; 雙流道分流密封內座; 醫療級矽膠 / TPE Shore A 60 (棕); Ø19.60 × 7.40 直抽芯模 / Ø3.10過盈; CSL-CAP-201-3; 一體式喇叭口透明外管; 醫療級高透明 PC (透光 ≥88%); Ø11.40喇叭→Ø4×32.56 單支拋光長芯針抽芯; CSL-CAP-201-4; 防脫底座靜態螺旋芯; 醫療級高流動 POM (暗紅塑鋼); Ø4.40底座 + 9節×28.0 左右對開哈夫滑塊模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

【#1 螺旋混合頭 — 四件式子零件清單 (4-PART SUB-ASSEMBLY BOM)】

醫療級 ABS / PP
(橄欖綠)

Outer Retaining Cap

Manifold Seal Seat

1-Pc Bell Cannula

Anti-Eject Helix Core

1. 原廠圖面像素比對確認（確為 4 組零件）：

放大檢視原廠商 CAD 剖面 (`混合頭.png`)，底部錐形喇叭口

與 Ø4.00 直管間完全連續無分件縫線，證實為「一體式喇叭

口透明外管 (1-3)」，全混合頭共由 4 件射出零件組成。

2. 免膠水機械夾持氣密 (Adhesive-Free Clamping)：

組裝順序：先將 ③(1-3) 由下往上穿出 ①(1-1) 頂孔 → 將

④(1-4) 由喇叭口向上塞入 → 最後壓入 ②(1-2) 矽膠座扣入

Ø19.70 扣槽。藉 ① 內錐面與 ② 彈性壓縮達成高壓氣密，

零溶劑/零 UV 膠殘留，符合 ISO 10993 生物相容性要求。

3. 物理防射出安全鎖定 (Positive Anti-Blowout Stop)：

1-4 螺旋芯尾部具 Ø4.40→Ø3.40 圓錐分流環 (> 直管內徑

#1 螺旋混合雙管蓋 — 四件式結構拆解總成與組裝剖視圖
PART #1 HELICAL STATIC MIXER CAP — 4-PART EXPLODED VIEW, SECTION B-B & BOM

材質 / MATERIAL:
ABS + SILICONE (SHORE A 60) + CLEAR PC + POM

圖號 / DWG NO.:
CSL-CAP-201-ASSY

比例 SCALE: 4.0 : 1 (SECTION)
REV C | SHEET 1 OF 5

單位 / UNIT & PROJ.:
mm | 第三角法 3RD ANGLE

## 全剖視圖 SECTION A-A (XZ 中心剖面, SCALE 7.5:1)

## 俯視防呆卡耳圖 (TOP VIEW, 3.0:1)

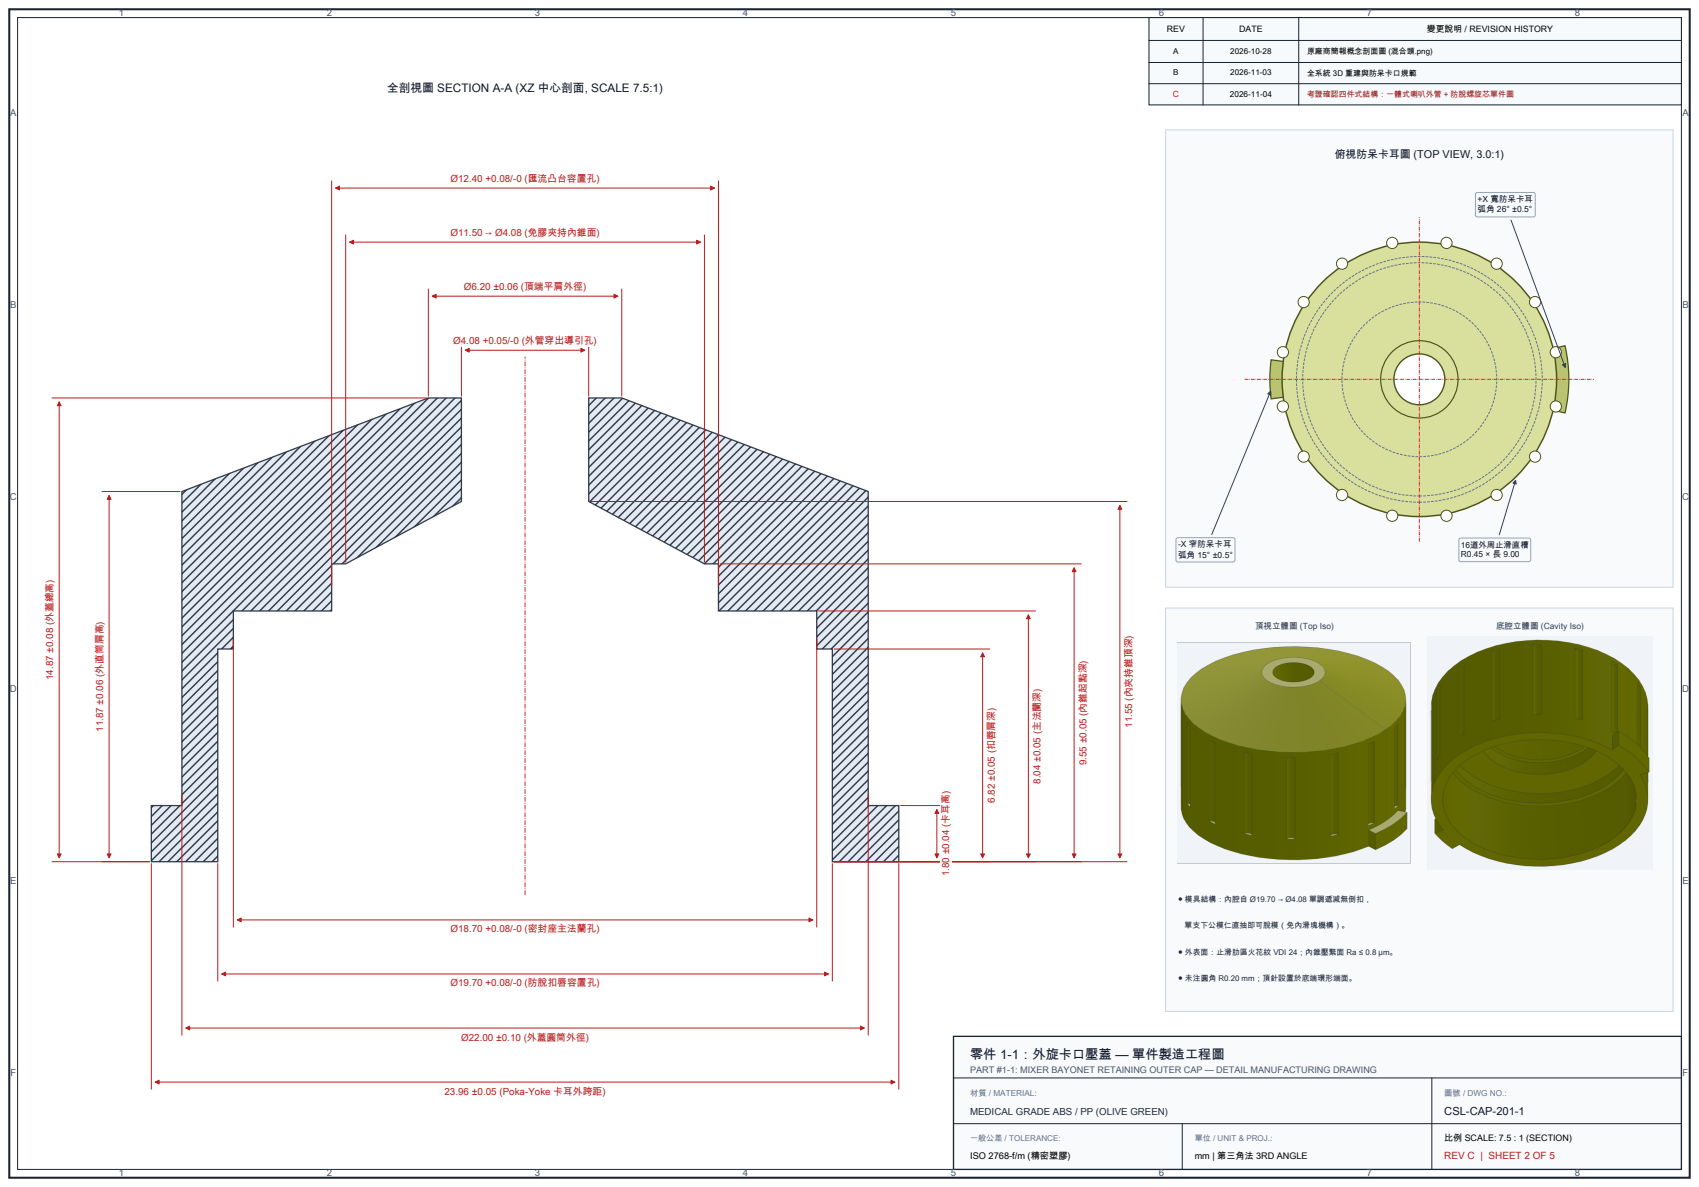
[picture p33: page 2]
考證確認四件式結構：一體式喇叭外管 + 防脫螺旋芯單件圖; 頂視立體圖 (Top Iso); 底腔立體圖 (Cavity Iso); 單支下公模仁直抽即可脫模（免內滑塊機構）。; 14.87 ±0.08 (外蓋總高); 11.87 ±0.06 (外直筒肩; 1.80 ±0.04 (卡耳高); 6.82 ±0.05 (扣唇肩深); 法蘭深); 9.55 ±0.05 (內錐起點深); 11.55 (內夾持錐頂; Ø4.08 +0.05/-0 (外管穿出導引孔); Ø6.20 ±0.06 (頂端平肩外徑); Ø11.50 → Ø4.08 (免膠夾持內錐面); Ø12.40 +0.08/-0 (匯流凸台容置孔); Ø18.70 +0.08/-0 (密封座主法蘭孔); Ø19.70 +0.08/-0 (防脫扣唇容置孔); Ø22.00 ±0.10 (外蓋圓筒外徑); +X 寬防呆卡耳 弧角 26° ±0.5°; -X 窄防呆卡耳 弧角 15° ±0.5°; 16道外周止滑直槽 R0.45 × 長 9.00

● 模具結構：內腔自 Ø19.70 → Ø4.08 單調遞減無倒扣，

● 外表面：止滑肋區火花紋 VDI 24；內錐壓緊面 Ra ≤ 0.8 µm。

● 未注圓角 R0.20 mm；頂針設置於底端環形端面。

零件 1-1：外旋卡口壓蓋 — 單件製造工程圖
PART #1-1: MIXER BAYONET RETAINING OUTER CAP — DETAIL MANUFACTURING DRAWING

23.96 ±0.05 (Poka-Yoke 卡耳外跨距)

材質 / MATERIAL:
MEDICAL GRADE ABS / PP (OLIVE GREEN)

圖號 / DWG NO.:
CSL-CAP-201-1

比例 SCALE: 7.5 : 1 (SECTION)

## 全剖視圖 SECTION B-B (XZ 雙流道中心剖面, SCALE 8.5:1)

## 俯視分流結構圖 (TOP VIEW, 3.6:1)

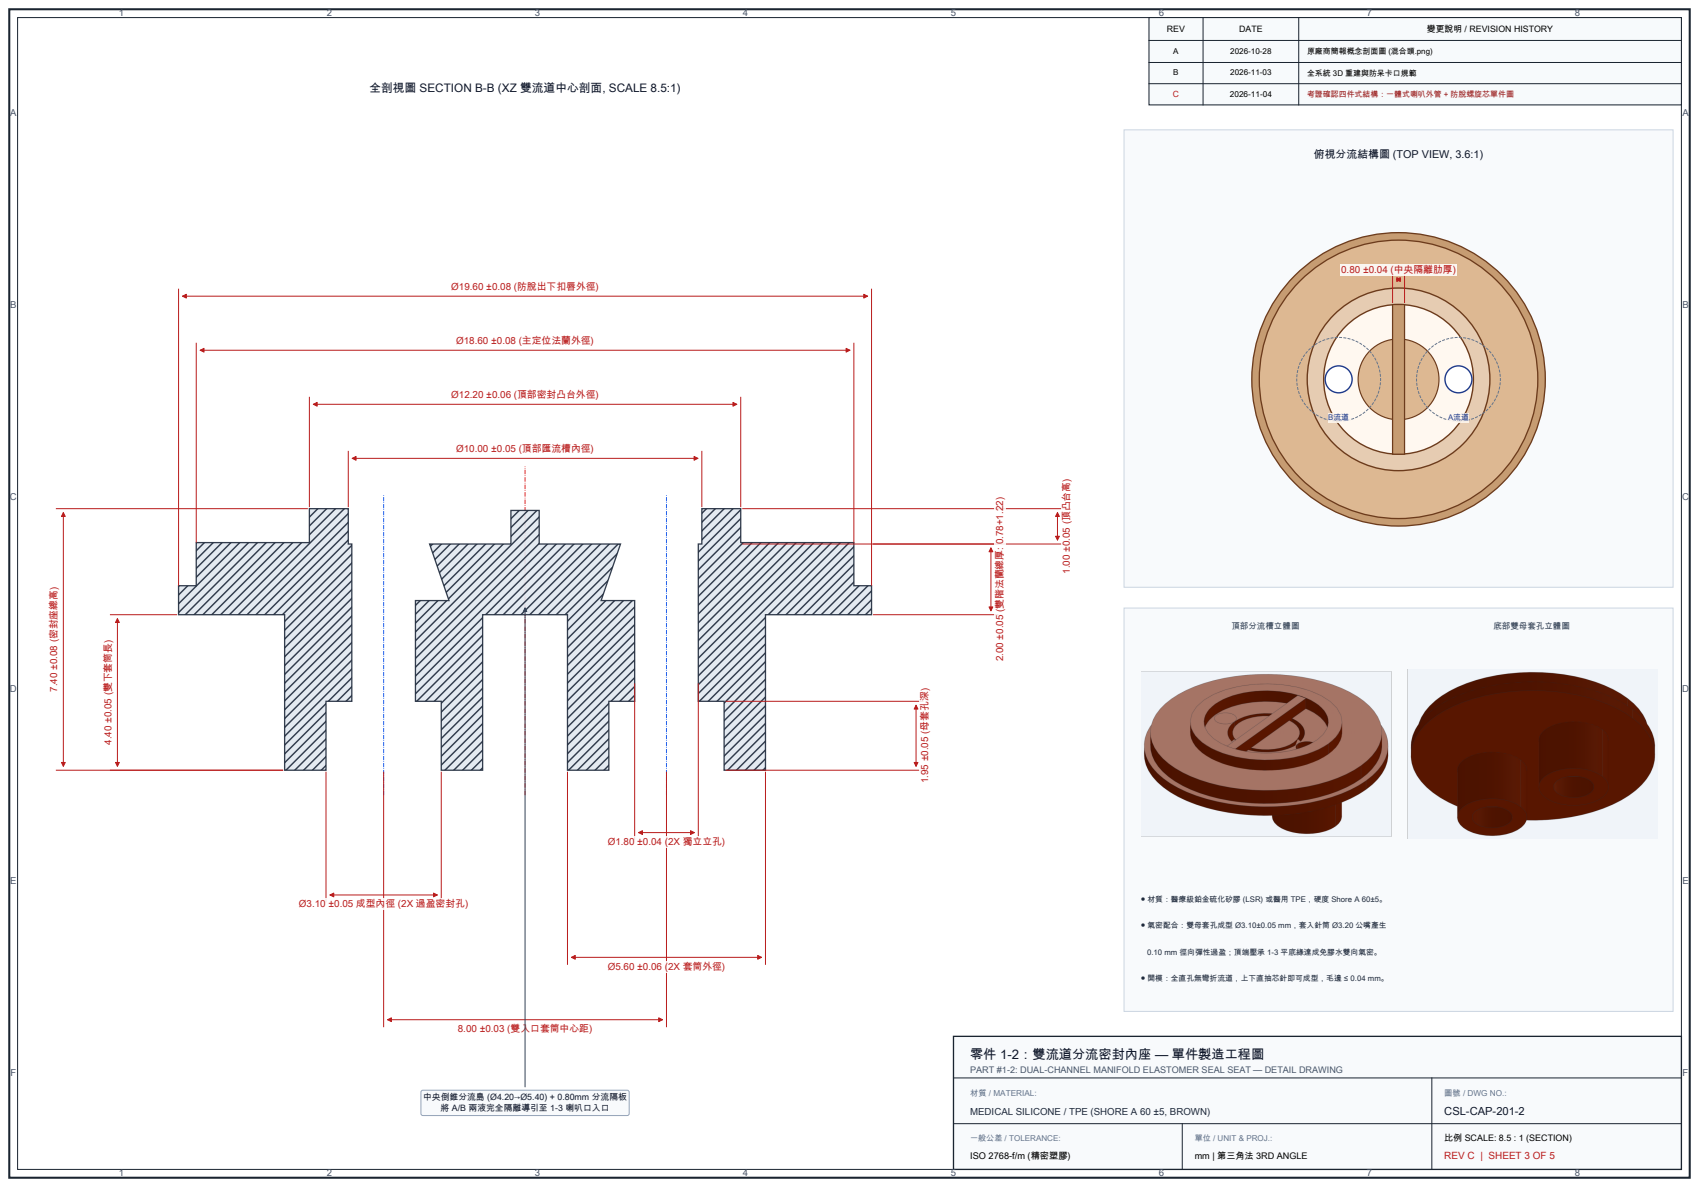
[picture p34: page 3]
考證確認四件式結構：一體式喇叭外管 + 防脫螺旋芯單件圖; 頂部分流槽立體圖; 底部雙母套孔立體圖; B流道; A流道; 7.40 ±0.08 (密封座總高); 4.40 ±0.05 (雙下套; 1.95 ±0.05 (母套孔; 頂凸台; Ø10.00 ±0.05 (頂部匯流槽內徑); Ø12.20 ±0.06 (頂部密封凸台外徑); Ø18.60 ±0.08 (主定位法蘭外徑); Ø19.60 ±0.08 (防脫出下扣唇外徑); Ø1.80 ±0.04 (2X 獨立立孔); Ø3.10 ±0.05 成型內徑 (2X 過盈密封孔); Ø5.60 ±0.06 (2X 套筒外徑); 8.00 ±0.03 (雙入口套筒中心距); 0.80 ±0.04 (中央隔離肋厚); 中央倒錐分流島 (Ø4.20→Ø5.40) + 0.80mm 分流隔板 將 A/B 兩液完全隔離導引至 1-3 喇叭口入口

● 材質：醫療級鉑金硫化矽膠 (LSR) 或醫用 TPE，硬度 Shore A 60±5。

● 氣密配合：雙母套孔成型 Ø3.10±0.05 mm，套入針筒 Ø3.20 公嘴產生

0.10 mm 徑向彈性過盈；頂端壓承 1-3 平底緣達成免膠水雙向氣密。

● 開模：全直孔無彎折流道，上下直抽芯針即可成型，毛邊 ≤ 0.04 mm。

零件 1-2：雙流道分流密封內座 — 單件製造工程圖
PART #1-2: DUAL-CHANNEL MANIFOLD ELASTOMER SEAL SEAT — DETAIL DRAWING

材質 / MATERIAL:
MEDICAL SILICONE / TPE (SHORE A 60 ±5, BROWN)

圖號 / DWG NO.:

比例 SCALE: 8.5 : 1 (SECTION)

## 全剖視圖 SECTION C-C (5.5:1)

## 局部放大圖 DETAIL D

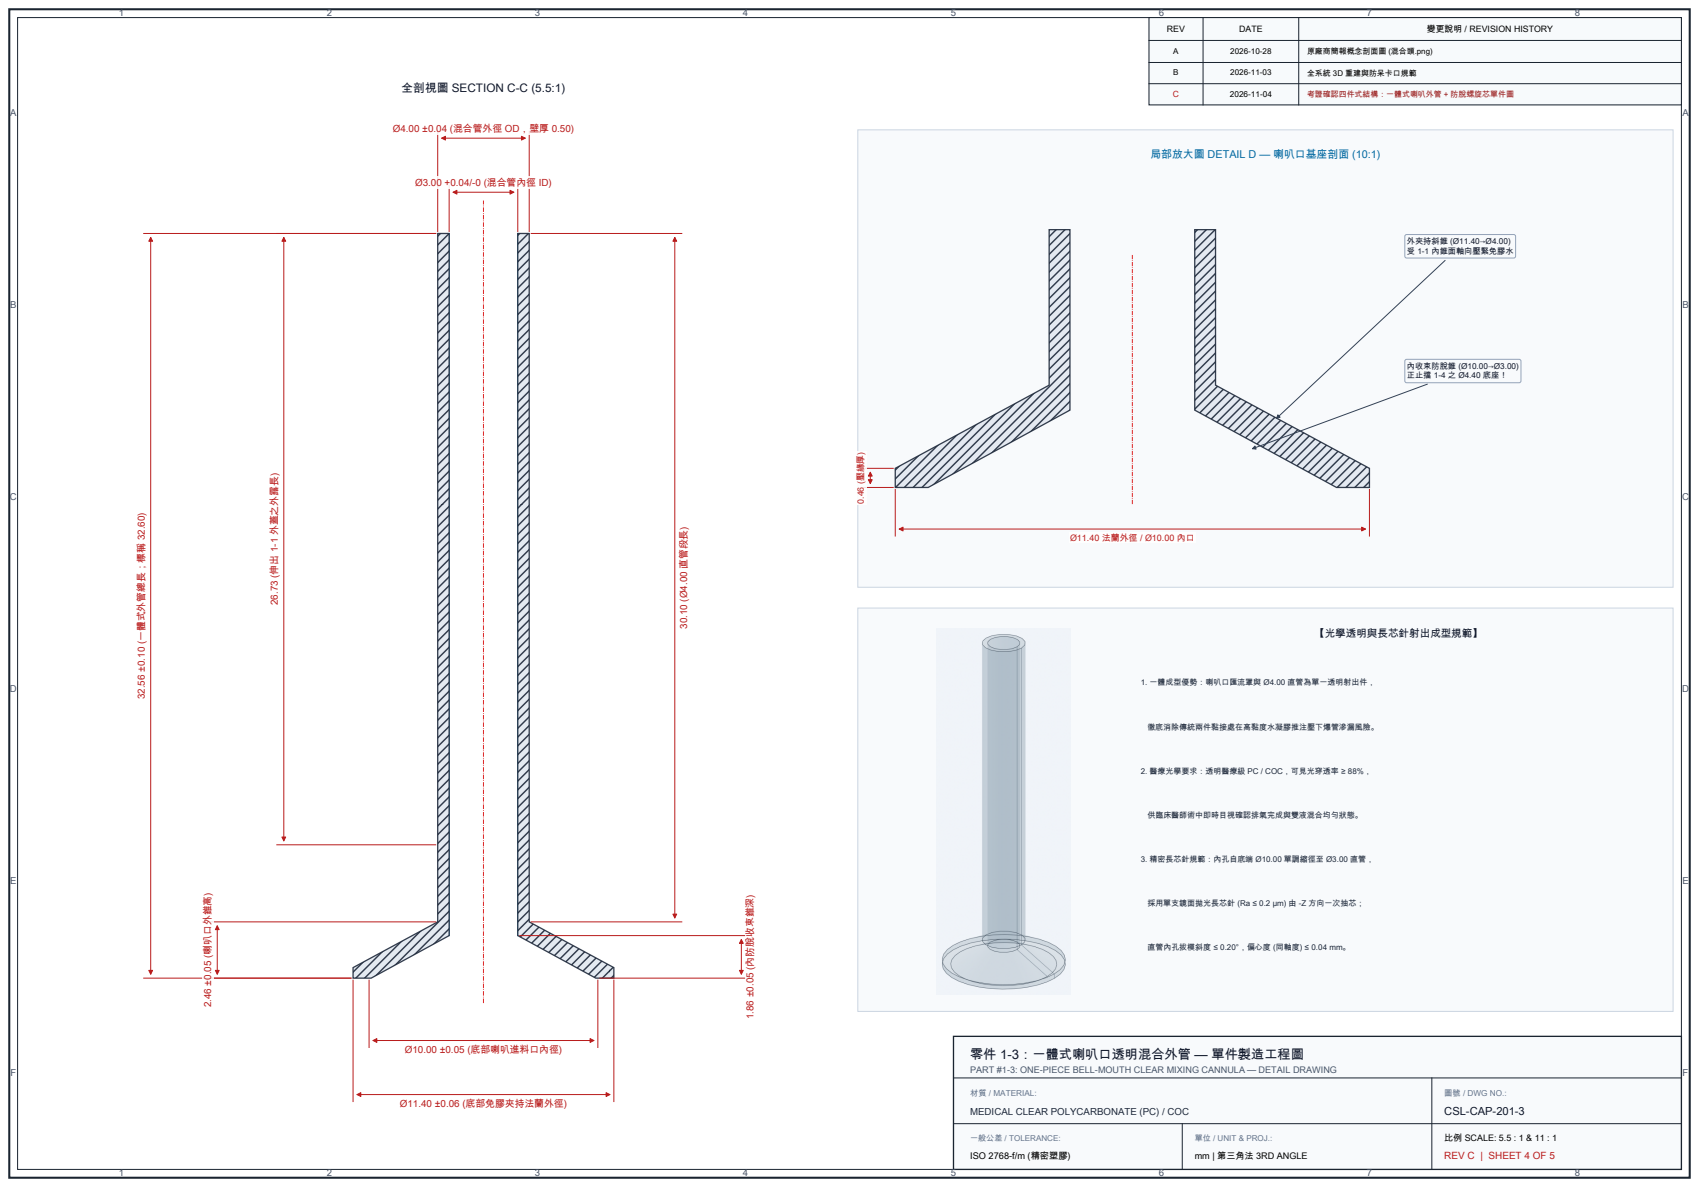
[picture p35: page 4]
REV; DATE; 變更說明 / REVISION HISTORY A; 原廠商簡報概念剖面圖 (混合頭.png) B; 全系統 3D 重建與防呆卡口規範 C; 考證確認四件式結構：一體式喇叭外管 + 防脫螺旋芯單件圖; — 單件製造工程圖 — DETAIL DRAWING; ISO 2768-f/m (精密塑膠; 比例 SCALE: 5.5 : 1 & 11 : 1; — 喇叭口; 基座剖面 (10:1); 學透明與長芯針射出成; 型規範】; 1. 一體成型優勢：喇叭口; 與 Ø4.00 直管為單一透明射出件，; 底消除傳; 兩件黏接處在高黏度水凝膠推注壓下爆管滲漏風險; 2. 醫療光; ，可見光穿透; 供臨床; 醫師術; 目視確認; 排氣完成與雙; 液混合均勻狀態。; 3. 精密長芯針規範：內孔自底; 調縮徑; 採用單支; 鏡面拋光長芯針 (Ra; 由 -Z 方向一; 次抽芯; 直管內孔; 偏心度 (同軸; 32.56 ±0.10 (一體式外管總長；標稱 32.60); 2.46 ±0.05 (喇叭口外錐高); 26.73 (伸出 1-1 外蓋之外露長)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

學要求：透明醫療級 PC / COC

零件 1-3：一體式喇叭口透明混合外管
PART #1-3: ONE-PIECE BELL-MOUTH CLEAR MIXING CANNULA

材質 / MATERIAL:
MEDICAL CLEAR POLYCARBONATE (PC) / COC

圖號 / DWG NO.:

正視圖 FRONT (0°, 6.2:1) | 右側視圖 RIGHT (90°, 6.2:1)

## 底部防脫分流環仰視圖 (12:1)

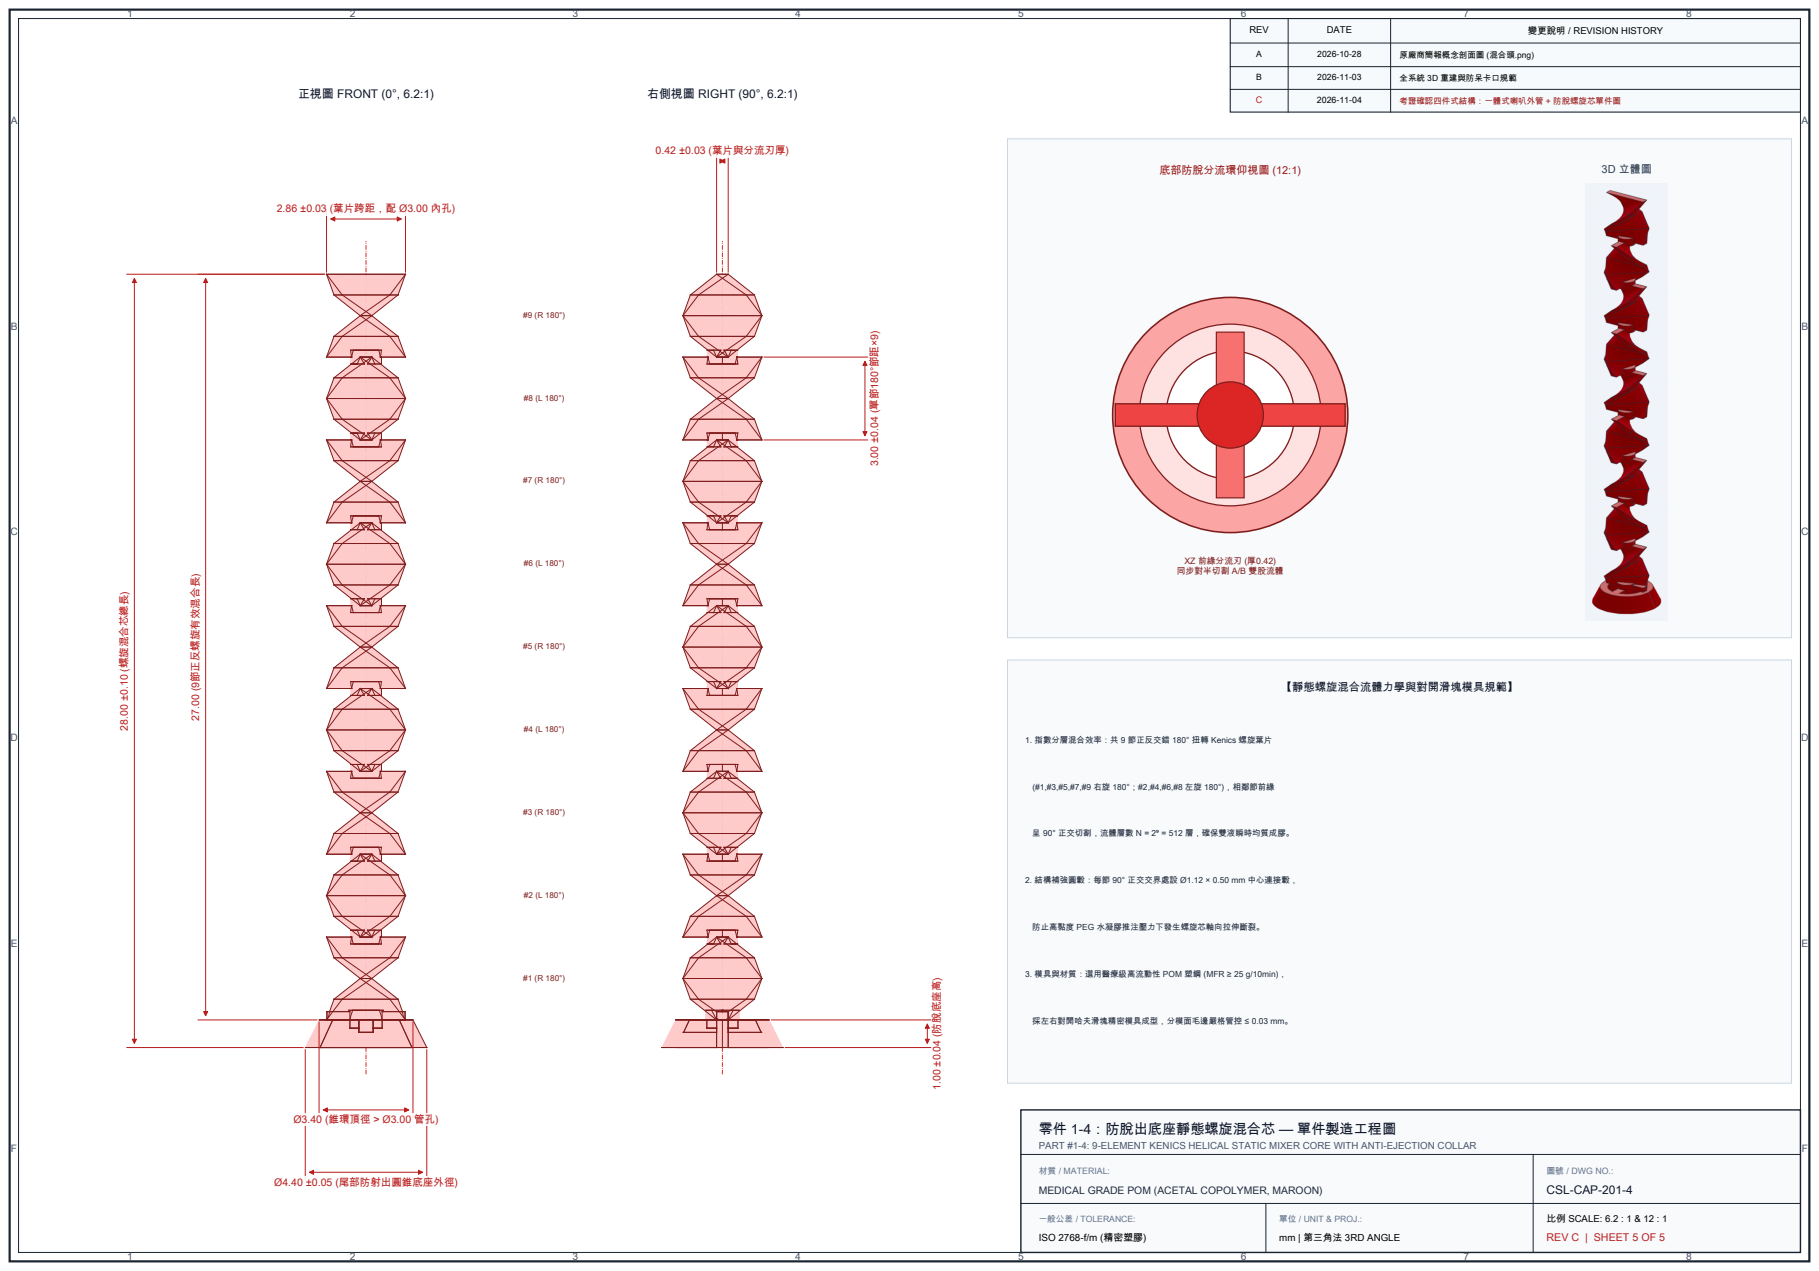
[picture p36: page 5]
考證確認四件式結構：一體式喇叭外管 + 防脫螺旋芯單件圖; 比例 SCALE: 6.2 : 1 & 12 : 1; XZ 前緣分流刃 (厚0.42) 同步對半切割 A/B 雙股流體; 3D 立體圖; 【靜態螺旋混合流體力學與對開滑塊模具規範】; 28.00 ±0.10 (螺旋混合芯總長); 節正反螺旋有效混合長); 1.00 ±0.04 (防脫底座高); 2.86 ±0.03 (葉片跨距，配 Ø3.00 內孔); 0.42 ±0.03 (葉片與分流刃厚); Ø3.40 (錐環頂徑 > Ø3.00 管孔); Ø4.40 ±0.05 (尾部防射出圓錐底座外徑)

1. 指數分層混合效率：共 9 節正反交錯 180° 扭轉 Kenics 螺旋葉片

(#1,#3,#5,#7,#9 右旋 180°；#2,#4,#6,#8 左旋 180°)，相鄰節前緣

呈 90° 正交切割，流體層數 N = 2⁹ = 512 層，確保雙液瞬時均質成膠。

2. 結構補強圓轂：每節 90° 正交交界處設 Ø1.12 × 0.50 mm 中心連接轂，

防止高黏度 PEG 水凝膠推注壓力下發生螺旋芯軸向拉伸斷裂。

3. 模具與材質：選用醫療級高流動性 POM 塑鋼 (MFR ≥ 25 g/10min)，

採左右對開哈夫滑塊精密模具成型，分模面毛邊嚴格管控 ≤ 0.03 mm。

零件 1-4：防脫出底座靜態螺旋混合芯 — 單件製造工程圖
PART #1-4: 9-ELEMENT KENICS HELICAL STATIC MIXER CORE WITH ANTI-EJECTION COLLAR

材質 / MATERIAL:
MEDICAL GRADE POM (ACETAL COPOLYMER, MAROON)

圖號 / DWG NO.:
