cybricks0025-tech/surgical-sealant/(commit log)

2026-08-21 feat: initial commit with 3D interactive viewer and CAD specifications
    [mixing_tip_prototype.scad]
2026-11-03 feat: add Rev.B CoSeal dual/single-barrel mixing device 3D interactive portal, B-Rep CAD models, and A3 engineering drawings
    [coseal_device_dispense.3mf, coseal_device_dispense.step, coseal_device_dispense.stl, coseal_system_overview.step, dual_barrel_body.step, dual_barrel_body.stl, dual_syringe_holder.3mf, dual_syringe_holder.step]
2026-11-03 feat(ui): add Minimalist Mode (pure 3D model view) toggle button and shortcut
2026-11-04 feat(mixer): add standalone 4-part mixer CAD scripts and STEP/STL/GLB files
    [mixer_4part_exploded.step, mixer_4part_exploded.stl, mixer_part1_outer_cap.step, mixer_part1_outer_cap.stl, mixer_part2_seal_seat.step, mixer_part2_seal_seat.stl, mixer_part3_bell_cannula.step, mixer_part3_bell_cannula.stl]
2026-11-04 feat(web): add 4-part mixer interactive 3D stage and dual blueprint deck viewer
2026-11-04 feat(cad): sync assembly STEP and STL models with 4-part helical mixer
    [coseal_device_dispense.step, coseal_device_dispense.stl, coseal_system_overview.step, helical_mixer_cap.step, helical_mixer_cap.stl]
2026-11-04 feat(glb): sync assembly GLB assets with 4-part helical mixer
2026-11-04 feat(3mf): sync multi-material 3MF with 4-part helical mixer
    [coseal_device_dispense.3mf]
